SnyUmd/KiCAD/spot/rx-8035_am.pdf

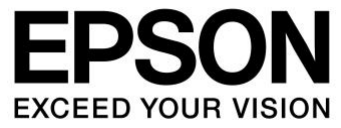
[picture p1: figure]

ETM35J-09

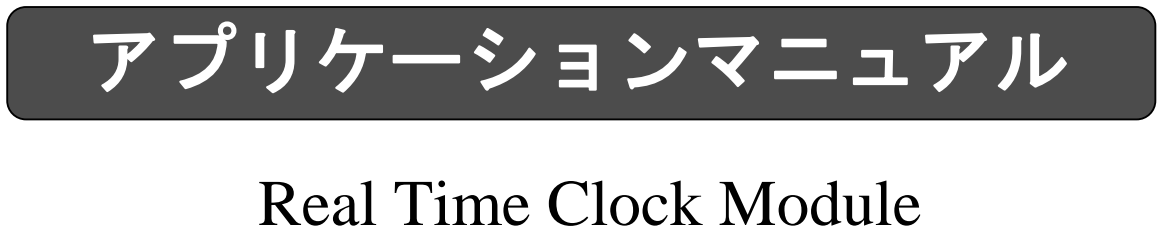
[picture p2: figure]
アプリケーションマニュアル; Real Time Clock Module

# Preliminary

# RX-8035SA/LC

### - 本マニュアルのご使用につきましては、次の点にご留意願います。

1. 本資料の内容については、予告なく変更することがあります。量産設計の際は最新情報をご確認ください。
2. 本資料の一部、または全部を弊社に無断で転載、または、複製など他の目的に使用することは堅くお断りいたします。
3. 本資料に記載される応用回路、プログラム、使用方法等はあくまでも参考情報であり、これらに起因する第三者の知 的財産権およびその他の権利侵害あるいは損害の発生に対し、弊社は如何なる保証を行うものではありません。また、 本資料によって第三者または弊社の知的財産権およびその他の権利の実施権の許諾を行うものではありません。
4. 特性表の数値の大小は、数値線上の大小関係で表します。
5. 輸出管理について
(1) 製品および弊社が提供する技術を輸出等するにあたっては「外国為替および外国貿易法」を遵守し、当該法令の定 める必要な手続をおとりください。
(2) 大量破壊兵器の開発等およびその他の軍事用途に使用する目的をもって製品および弊社が提供する技術を輸出等 しないでください。また、これらに使用するおそれのある第三者に提供しないでください。
6. 製品は一般電子機器に使用されることを意図し設計されたものです。 特別に高信頼性を必要とする以下の特定用途に 使用する場合は、弊社の事前承諾を必ず得て下さい。 承諾無き場合は如何なる責任も負いかねることがあります。 1 宇宙機器（人工衛星・ロケット等）2 輸送車両並びにその制御機器（自動車・航空機・列車・船舶等）
3 生命維持を目的とした医療機器 4 海底中継機器 5 発電所制御機器 6 防災・防犯装置7 交通用機器
8 その他；1 ～7 と同等の信頼性を必要とする用途

本資料に掲載されている会社名、商品名は、各社の商標もしくは登録商標です。

# ETM35J 改定履歴

Rev No. | Date | Page | Description
-05 | 2013/06/10 | | 制定
-08 | 2014/06/18 | 4 | プルダウン抵抗値の仕様記載
| | 15 | タイミングチャート修正：VDD→VOUT 等
-09 | 2017/9/20 | 13,20,30 | VDET に関して 秒桁書き込み後は VDET をクリアしてください。
| | 13 | VDET に関して 2:VDET は VBAT 電圧を監視しています。
| | 7 | 電源切替に関して 電池を先入れする際の注意事項追加
| | 29 | フローチャート新規追加

## RX - 8035 SA / LC

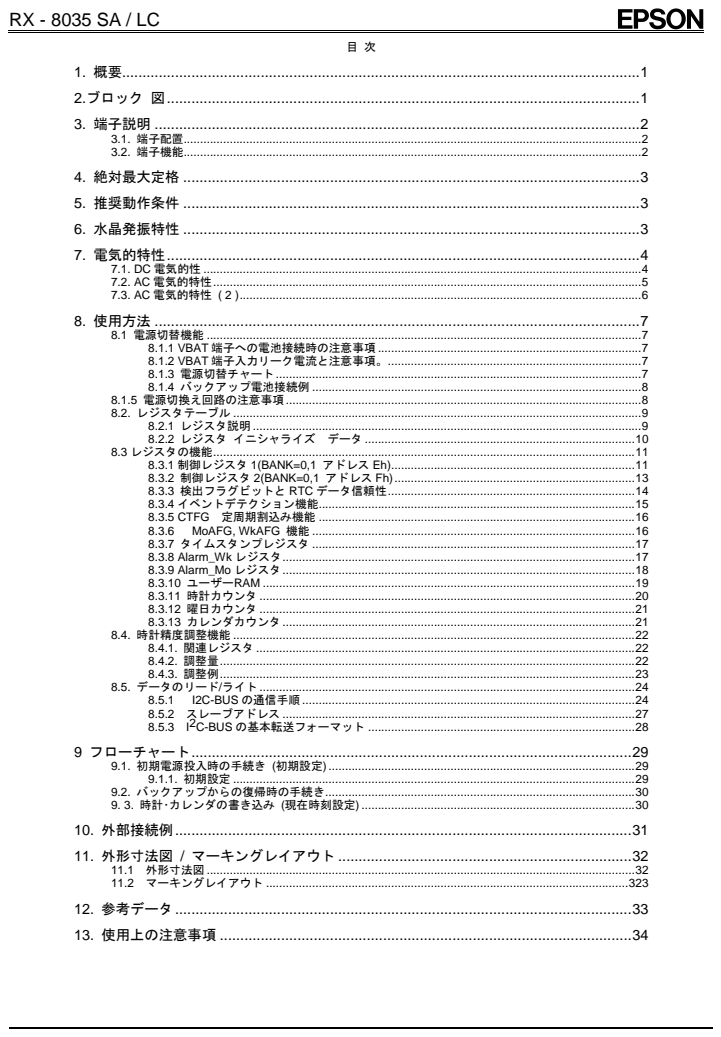
[picture p3: page 4]
2.ブロック 図....................................................................................................................1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

8.2.1 レジスタ説明 ......................................................................................................................9
8.2.2 レジスタ イニシャライズ データ ..................................................................................10

8.3.1 制御レジスタ 1(BANK=0,1 アドレス Eh)..........................................................................11
8.3.2 制御レジスタ 2(BANK=0,1 アドレス Fh).........................................................................13
8.3.3 検出フラグビットと RTC データ信頼性...........................................................................14
8.3.4 イベントデテクション機能................................................................................................15
8.3.5 CTFG 定周期割込み機能 ................................................................................................16
8.3.7 タイムスタンプレジスタ ..................................................................................................17
8.3.8 Alarm_Wk レジスタ...........................................................................................................17
8.3.9 Alarm_Mo レジスタ...........................................................................................................18
8.3.10 ユーザーRAM .................................................................................................................19
8.3.11 時計カウンタ ..................................................................................................................20
8.3.12 曜日カウンタ ..................................................................................................................21
8.3.13 カレンダカウンタ...........................................................................................................21

9.2. バックアップからの復帰時の手続き..............................................................................................30
9. 3. 時計･カレンダの書き込み (現在時刻設定) ...................................................................................30
10. 外部接続例................................................................................................................31

1. 概要

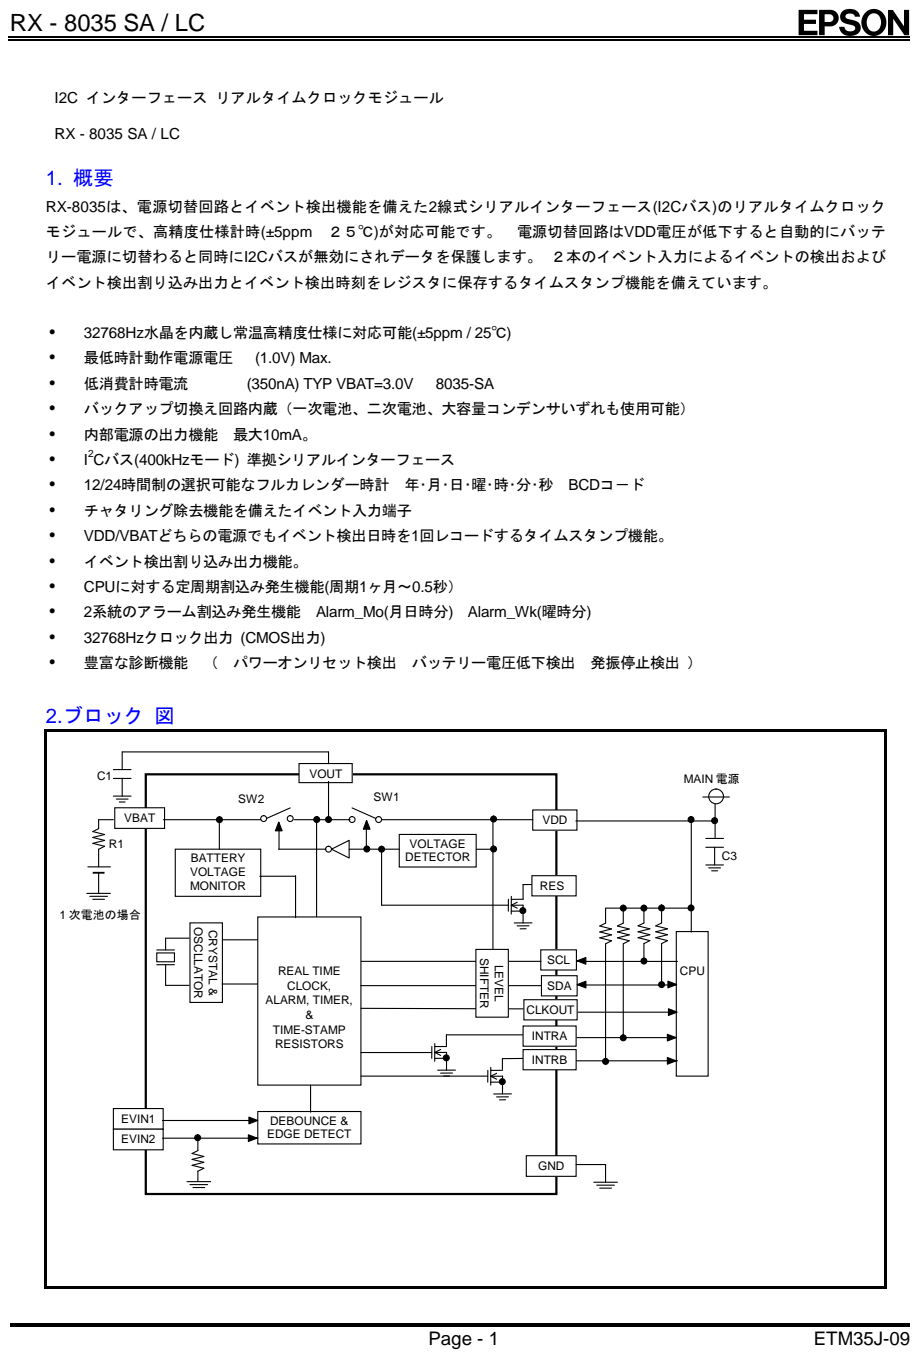
[picture p4: page 5]
Page - 1; ETM35J-09; I2C インターフェース リアルタイムクロックモジュール; 最低時計動作電源電圧; (1.0V) Max.; 低消費計時電流; (350nA) TYP VBAT=3.0V; 2.ブロック 図; GND; VOUT; MAIN 電源; VBAT; VDD; REAL TIME; CPU; CLOCK, ALARM, TIMER, & TIME-STAMP RESISTORS; SDA; BATTERY; VOLTAGE MONITOR; VOLTAGE DETECTOR; CLKOUT; INTRA; INTRB; EVIN1; DEBOUNCE &; EDGE DETECT; OSCLLATOR; CRYSTAL &; EVIN2; RES; SCL; 1 次電池の場合; LEVEL; SHIFTER

RX-8035は、電源切替回路とイベント検出機能を備えた2線式シリアルインターフェース(I2Cバス)のリアルタイムクロック
モジュールで、高精度仕様計時(±5ppm ２５℃)が対応可能です。 電源切替回路はVDD電圧が低下すると自動的にバッテ
リー電源に切替わると同時にI2Cバスが無効にされデータを保護します。 ２本のイベント入力によるイベントの検出および
イベント検出割り込み出力とイベント検出時刻をレジスタに保存するタイムスタンプ機能を備えています。

32768Hz水晶を内蔵し常温高精度仕様に対応可能(±5ppm / 25℃)
バックアップ切換え回路内蔵（一次電池、二次電池、大容量コンデンサいずれも使用可能）
内部電源の出力機能 最大10mA。
2Cバス(400kHzモード) 準拠シリアルインターフェース
12/24時間制の選択可能なフルカレンダー時計 年･月･日･曜･時･分･秒 BCDコ－ド
チャタリング除去機能を備えたイベント入力端子
VDD/VBATどちらの電源でもイベント検出日時を1回レコードするタイムスタンプ機能。
イベント検出割り込み出力機能。
CPUに対する定周期割込み発生機能(周期1ヶ月～0.5秒）
2系統のアラーム割込み発生機能 Alarm_Mo(月日時分) Alarm_Wk(曜時分)
32768Hzクロック出力 (CMOS出力)
豊富な診断機能 （ パワーオンリセット検出 バッテリー電圧低下検出 発振停止検出 ）

## 3. 端子説明

### RX - 8035 LC

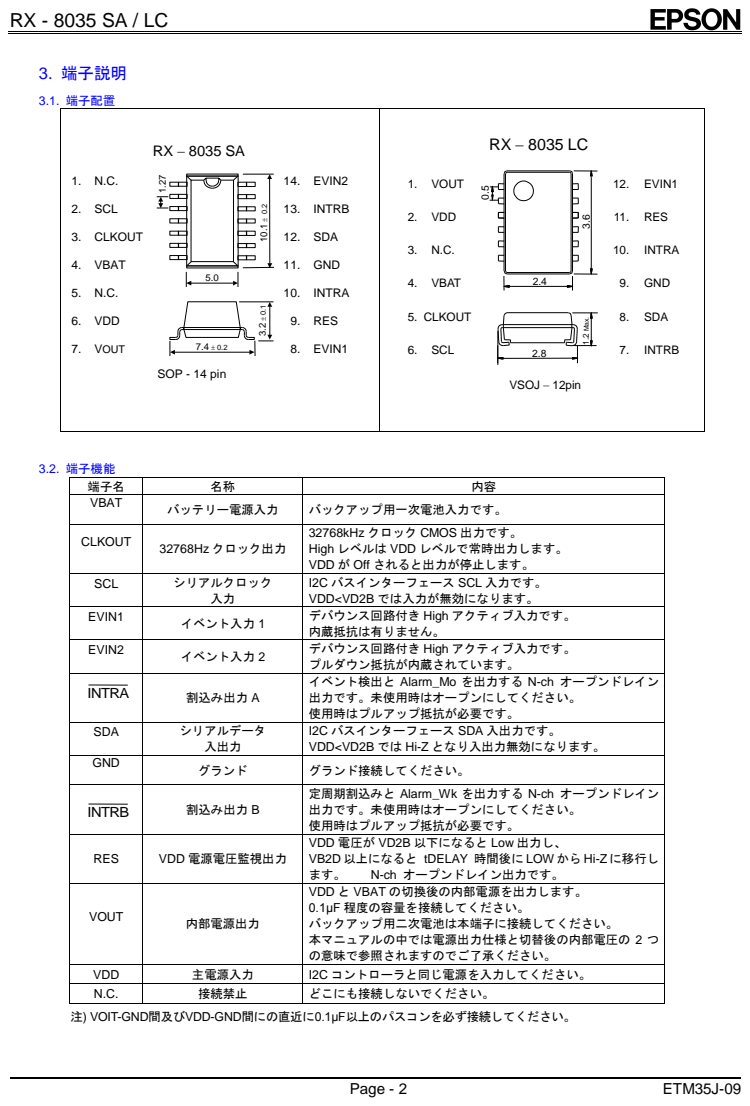
[picture p5: page 6]
Page - 2; ETM35J-09; 3.1. 端子配置; 3.2. 端子機能; 注) VOIT-GND間及びVDD-GND間にの直近に0.1μF以上のパスコンを必ず接続してください。; VOUT; EVIN1; VDD; RES; INTRA; VBAT; GND; 5. CLKOUT; SDA; 6. SCL; 3.6 1.2 Max.; 7. INTRB; VSOJ - 12pin; 14. EVIN2; 2. SCL; 13. INTRB; 3. CLKOUT; 12. SDA; 4. VBAT; 11. GND; 10. INTRA; 6. VDD; 9. RES; 7. VOUT; 8. EVIN1; SOP - 14 pin

端子名 | 名称 | 内容
VBAT | バッテリー電源入力 | バックアップ用一次電池入力です。

CLKOUT | 32768Hz クロック出力 | 32768kHz クロック CMOS 出力です。 High レベルは VDD レベルで常時出力します。 VDD が Off されると出力が停止します。

SCL | シリアルクロック 入力 | I2C バスインターフェース SCL 入力です。 VDD<VD2B では入力が無効になります。

EVIN1 | イベント入力 1 | デバウンス回路付き High アクティブ入力です。 内蔵抵抗は有りません。

EVIN2 | イベント入力 2 | デバウンス回路付き High アクティブ入力です。 プルダウン抵抗が内蔵されています。

INTRA | 割込み出力 A | イベント検出と Alarm_Mo を出力する N-ch オープンドレイン 出力です。未使用時はオープンにしてください。 使用時はプルアップ抵抗が必要です。

SDA | シリアルデータ 入出力 | I2C バスインターフェース SDA 入出力です。 VDD<VD2B では Hi-Z となり入出力無効になります。

GND | グランド | グランド接続してください。

INTRB | 割込み出力 B | 定周期割込みと Alarm_Wk を出力する N-ch オープンドレイン 出力です。未使用時はオープンにしてください。 使用時はプルアップ抵抗が必要です。

RES | VDD 電源電圧監視出力 | VDD 電圧が VD2B 以下になると Low 出力し、 VB2D 以上になると tDELAY 時間後に LOW から Hi-Z に移行し ます。 N-ch オープンドレイン出力です。

VOUT | 内部電源出力 | VDD と VBAT の切換後の内部電源を出力します。 0.1μF 程度の容量を接続してください。 バックアップ用二次電池は本端子に接続してください。 本マニュアルの中では電源出力仕様と切替後の内部電圧の 2 つ の意味で参照されますのでご了承ください。

VDD | 主電源入力 | I2C コントローラと同じ電源を入力してください。
N.C. | 接続禁止 | どこにも接続しないでください。

4. 絶対最大定格 | GND=0 V

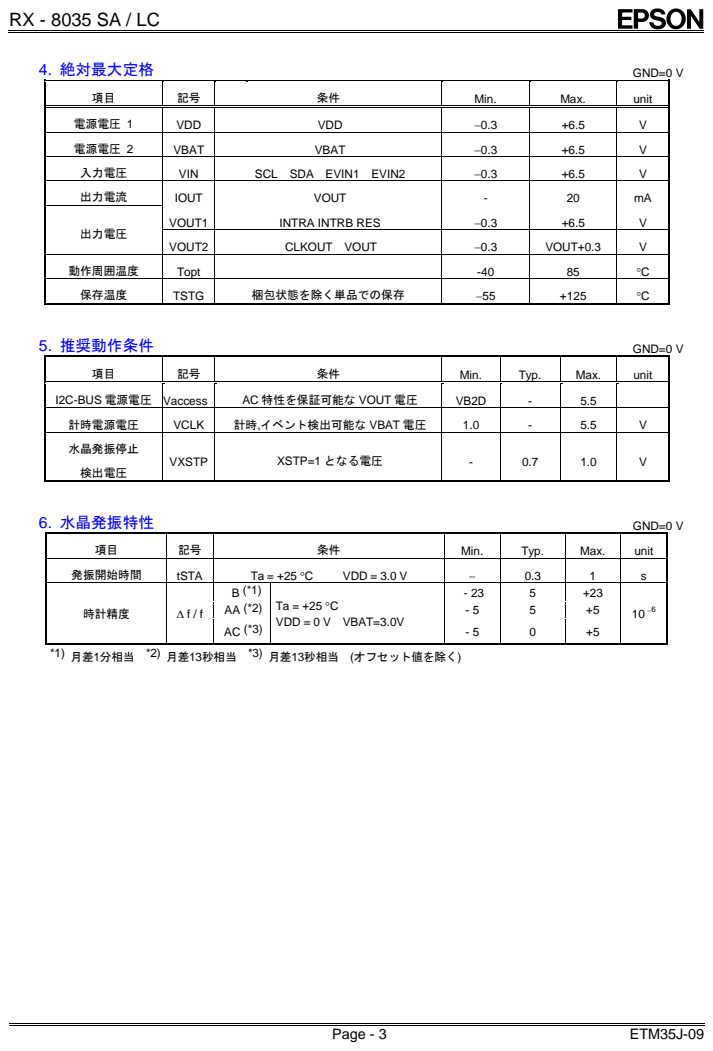
[picture p6: page 7]
Page - 3; ETM35J-09; 5. 推奨動作条件; GND=0 V; 6. 水晶発振特性; *1) 月差1分相当 *2) 月差13秒相当 *3) 月差13秒相当 (オフセット値を除く)

項目 | 記号 | 条件 | Min. | Max. | unit

電源電圧 1 | VDD | VDD | -0.3 | +6.5 | V

電源電圧 2 | VBAT | VBAT | -0.3 | +6.5 | V

入力電圧 | VIN | SCL SDA EVIN1 EVIN2 | -0.3 | +6.5 | V

出力電流 | IOUT | VOUT | - | 20 | mA

出力電圧 | VOUT1 | INTRA INTRB RES | -0.3 | +6.5 | V

VOUT2 | CLKOUT VOUT | -0.3 | VOUT+0.3 | V

動作周囲温度 | Topt | | -40 | 85 | °C

保存温度 | TSTG | 梱包状態を除く単品での保存 | -55 | +125 | °C

項目 | 記号 | 条件 | Min. | Typ. | Max. | unit

I2C-BUS 電源電圧 | Vaccess | AC 特性を保証可能な VOUT 電圧 | VB2D | - | 5.5

計時電源電圧 | VCLK | 計時,イベント検出可能な VBAT 電圧 | 1.0 | - | 5.5 | V

水晶発振停止 検出電圧 | VXSTP | XSTP=1 となる電圧 | - | 0.7 | 1.0 | V

発振開始時間 | tSTA | Ta = +25 °C VDD = 3.0 V | - | 0.3 | 1 | s
時計精度 | Δ f / f | B (*1) | Ta = +25 °C VDD = 0 V VBAT=3.0V | - 23 | 5 | +23

Page - 4 | ETM35J- 09

## 7. 電気的特性

7.1. DC 電気的性

なき場合:GND=0V, VDD=3.0V, Topt=-40～+85°C,
記号 | 項 目 | 端 子 名 | 測定条件 | 最小 | 標準 | 最大 | 単位
VIH1 | “H” 入力電圧 | SCL, SDA | VDD =VB2D～5.5V | 0.8x VDD | | 5.5 | V
VIL1 | “L” 入力電圧 | | | -0.3 | | 0.2x VDD
VIH2 | “H” 入力電圧 | EVIN1, EVIN2 | VOUT=1.0～5.5V | 0.8x VOUT | | 5.5 | V
VIL2 | “L” 入力電圧 | | | -0.3 | | 0.3
IOH | “H” 出力電流 | CLKOUT | VOH=VDD-0.5V | | | -0.5 | mA
IOL1 | “L” 出力電流 | CLKOUT | VOL=0.4V | 0.5 | | | mA
IOL2 | | INTRA , INTRB VDCC | | 2.0
IOL3 | | SDA | | 3.0
IIL | 入力リーク電流 | SCL EVIN1 | VI=5.5V or GND | -0.2 | | 0.2 | µA
IOZ | オフ状態出力 リーク電流 | INTRA , INTRB VDCC , SDA | VO=5.5V or GND | -0.2 | | 0.2 | µA
RDN | プルダウン 抵抗値 | EVIN2 | | 40 | 120 | 400 | kΩ
VD2B | VDD→VBAT 切換電圧 | VDD | Topt=+25°C | 2.328 | 2.40 | 2.472 | V
VB2D | VBAT→VDD 切換電圧 | VDD | Topt=+25°C | 2.396 | 2.52 | 2.544 | V
ΔVDET ΔTopt | 切換電圧 温度係数 | VDD | Topt=-40～+85°C | | ±100 | | ppm/ °C
VDET | VBAT 電圧低下 検出電圧 | VBAT | Topt=-30 to +70°C | 1.10 | 1.25 | 1.40 | V
VOUT1 | VOUT出力電圧 1 | VOUT | Topt=+25°C, VDD=3.0V Iout = 10mA | VDD -0.12 | VDD -0.03 | | V
VOUT2 | VOUT出力電圧 2 | VOUT | Topt=+25°C, VDD=2.0V VBAT=3.0V Iout = 100µA | VBAT -0.08 | VBAT -0.03 | | V
IBATL | VDD オン時 VBAT 端子漏れ電流 | VBAT | VDD=3.0V VBAT=0V or 5.5V SCL=SDA=0V CLKOUT = OPEN | -1.0 | 0.01 | 1.0 | µA
IBAT1 | RX 8035 SA 計時消費電流 | VBAT | VDD=0V VBAT=3V SCL=SDA=0V EVIN1=EVIN2= GND VLKOUT = OPEN | - | 350 | 1200 | nA
IBAT2 | RX 8035 LC 計時消費電流 | | | | 400
IDD | VDD 消費電流 | VDD | VDD=3V, VBAT=0V SCL=SDA=0V EVIN1=EVIN2=GND CLKOUT = OPEN | - | 1400 | 2500 | nA

### ( *1) 入力リーク電流 参考値

条件: SCL 端子 VOUT=3.0V VIN=0V or 5.5V -40°C ~ +85°C

### 上記条件で任意ロットにおけるワースト値：±17nA

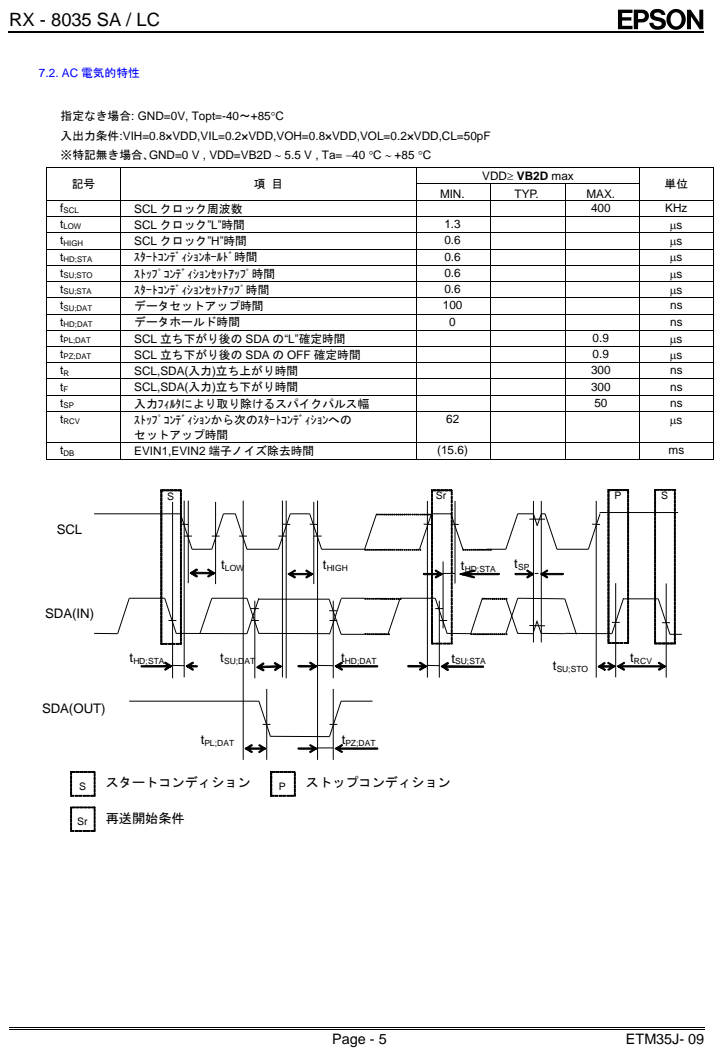
[picture p7: page 9]
Page - 5; ETM35J- 09; 7.2. AC 電気的特性; SDA(OUT); SCL; tPZ;DAT; tHIGH; tSU;DAT; tHD;STA; tSP; tSU;STO; tLOW; tSU;STA; SDA(IN); tPL;DAT; スタートコンディション; ストップコンディション; 再送開始条件; tHD;DAT; tRCV

指定なき場合: GND=0V, Topt=-40～+85°C
入出力条件:VIH=0.8×VDD,VIL=0.2×VDD,VOH=0.8×VDD,VOL=0.2×VDD,CL=50pF
※特記無き場合､GND=0 V , VDD=VB2D ~ 5.5 V , Ta= -40 °C ~ +85 °C

記号 | 項 目 | VDD≥ VB2D max | 単位

MIN. | TYP. | MAX.

fSCL | SCL クロック周波数 | | | 400 | KHz
tLOW | SCL クロック”L”時間 | 1.3 | | | µs
tHIGH | SCL クロック”H”時間 | 0.6 | | | µs
tHD;STA | ｽﾀｰﾄｺﾝﾃﾞｨｼｮﾝﾎｰﾙﾄﾞ時間 | 0.6 | | | µs
tSU;STO | ｽﾄｯﾌﾟｺﾝﾃﾞｨｼｮﾝｾｯﾄｱｯﾌﾟ時間 | 0.6 | | | µs
tSU;STA | ｽﾀｰﾄｺﾝﾃﾞｨｼｮﾝｾｯﾄｱｯﾌﾟ時間 | 0.6 | | | µs
tSU;DAT | データセットアップ時間 | 100 | | | ns
tHD;DAT | データホールド時間 | 0 | | | ns
tPL;DAT | SCL 立ち下がり後の SDA の“L”確定時間 | | | 0.9 | µs
tPZ;DAT | SCL 立ち下がり後の SDA の OFF 確定時間 | | | 0.9 | µs
tR | SCL,SDA(入力)立ち上がり時間 | | | 300 | ns
tF | SCL,SDA(入力)立ち下がり時間 | | | 300 | ns
tSP | 入力ﾌｨﾙﾀにより取り除けるスパイクパルス幅 | | | 50 | ns
tRCV | ｽﾄｯﾌﾟｺﾝﾃﾞｨｼｮﾝから次のｽﾀｰﾄｺﾝﾃﾞｨｼｮﾝへの セットアップ時間 | 62 | | | µs

tDB | EVIN1,EVIN2 端子ノイズ除去時間 | (15.6) | | | ms

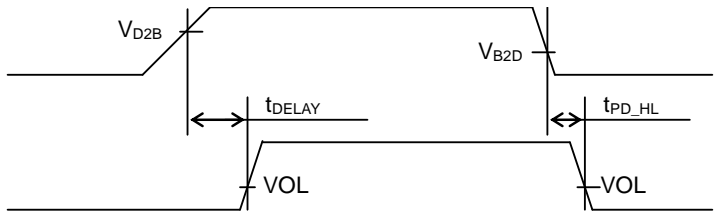
[picture p8: figure]
tDELAY; VOL; tPD_HL
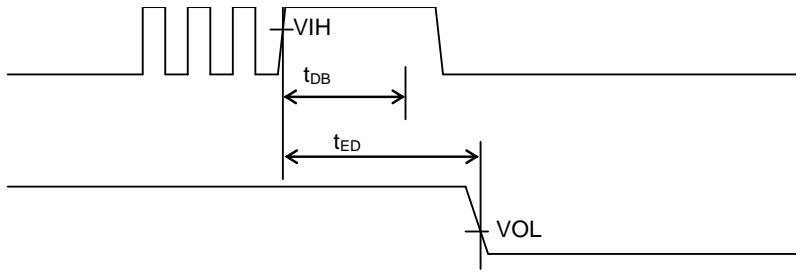
[picture p9: figure]
tDB; VOL; VIH; tED

Page - 6 | ETM35J- 09
7.3. AC電気的特性 ( 2 )

指定なき場合: GND=0V, Topt=-40～+85°C, VBAT=3.0V 入出力条件:CL=50pF
記号 | 項 目 | 測定条件 | MIN. | TYP. | MAX. | 単位
tDELAY | ボルテージディテクタ 出力遅延時間 | 計時動作時、VOUT ≥ VB2D | Typ -4 | (105) | Typ +4 | ms
tPD_HL | ボルテージディテクタ 伝播遅延時間 | | | 15 | | µs
*1) tDB | EVIN1,EVIN2 端子 ノイズ除去時間 | 計時動作時 | Typ -4 | 35 or 1996 | Typ +4 | ms
tED | イベント入力検出時間 | 計時動作時 | Typ -4 | tDB+7.8 | Typ +4 | ms

*1) tDBはDBSLビットで35ms or 1996msが選択可能です。

RES

VDD

INTRA

EVIN

Page - 7 | ETM35J- 09

## 8. 使用方法

8.1 電源切替機能

RX-8035 は 3 つの電源端子(VOUT,VDD,VBAT)を持っています。VOUT は RTC の内部電源が現れます。

VDD 電源電圧が VD2B より低いときは VBAT から電源が自動供給されて VOUT には VBAT 電圧が現れ、

VB2D より高い場合は、VDD から電源が供給されて VOUT には VDD 電圧が現れます。 VDD電源電圧がVD2B電圧より低下するとI

2Cバスインターフェースが自動的に無効になりRTC内部データ

が保護されます。
8.1.1 VBAT 端子への電池接続時の注意事項

電源切替回路はVDD電源の供給によって初期化されるため、VDDが供給される前にバックアップ用電池をセットされた場合は VDD電源で動作する電源切替SWが初期化されずVBAT端子に100μA前後のリーク電流が流れ込む事が有ります。 このような電池先入れ時のリーク電流を解消するためには以下のいずれかの処理を実施してください。
1) VDD供給状態で電池をセットしてください。
2) 電池セット後に2.47V以上の電圧を10ms以上VDD端子に供給してください。
3) 2.47V以上の電池セット後にVBAT端子とVDD端子を10ms以上ショートしてください。 OFF状態のVDDのインピーダンスが低い場合はVBATの電池電圧がVDDに引き込まれて2.47Vに達しない場合も想定されま す。
ショート時のVDD電圧をご確認ください。
以上の処理以降はVDD,VBATの電圧変動に追従して切替動作が行われリーク電流が発生することは有りません。

8.1.2 VBAT 端子入力リーク電流と注意事項。

本書 7.2 DC 電気的特性仕様の IBATL 特性の任意ロットにおける参考値は以下のとおりです。

VDD = 3.0V VBAT = 5.5V : Max:+9nA (-40 °C ~ +85 °C)

VDD = 3.0V VBAT = 0.0V : Max:-3nA (-40 °C ~ +85 °C)
VDD電圧がVD2B(Typ. 2.4V), VB2D(Typ. 2.47V) 付近ではVDD側およびVBAT側の切替SWが両方ONまたはOFFに近 い状態となりVDD-VBAT間がショートされる、あるいはどちらからも電源供給されないような瞬間があります。 VDD電圧が上記の切替電圧付近に停滞せず、できるだけ速やかにMAX～MIN間を遷移するようにご配慮ください。 8.1.3 電源切替チャート

下図にVDDとVBATとVOUTの関係をタイミングチャートで示します。

VOUT

VB2D

VDD
0V

VBAT

0V

I | II | III | II | III

VD2B

状態 | II | IV

上記タイミングチャートの説明
状態 | 説明
I | VDD,VBAT 端子共に 0V の時に VDD だけを供給していくと、徐々に内部電源に供給され、VOUT は VDD の半分くらいの電圧で追従します。
II | VDD が VB2D を超えると、VOUT は VDD と等しい電圧まで上昇し、その後、VDD に追従します。 VDD が VB2D より高い電圧では VDD=VOUT となります。
III | VDD が VD2B を下回ると、VOUT は VBAT と等しくなります。
IV | VDD 供給が無い状態(初期電源投入)で VBAT だけが供給されると、VDD が供給されるまでは VOUT が不安定になり、VBAT 端子に 100μA 前後の入力リーク電流が生じる場合が有ります。

電源切換回路が不安定です。

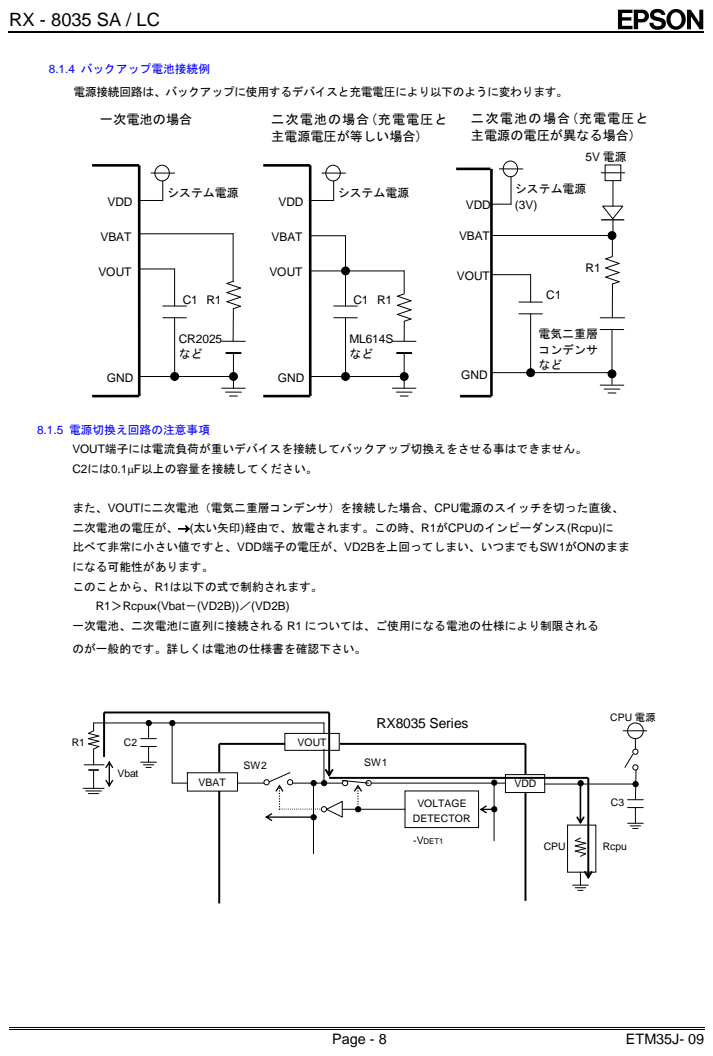
[picture p10: page 12]
Page - 8; ETM35J- 09; 8.1.4 バックアップ電池接続例; 電源接続回路は、バックアップに使用するデバイスと充電電圧により以下のように変わります。; 8.1.5 電源切換え回路の注意事項; VOUT端子には電流負荷が重いデバイスを接続してバックアップ切換えをさせる事はできません。; C2には0.1µF以上の容量を接続してください。; のが一般的です。詳しくは電池の仕様書を確認下さい。; VBAT; VOUT; VDD; GND; システム電源; 電気二重層 コンデンサ など; 二次電池の場合(充電電圧と 主電源の電圧が異なる場合); 二次電池の場合(充電電圧と 主電源電圧が等しい場合); 一次電池の場合; CPU 電源; VOLTAGE; DETECTOR; CPU; Vbat; Rcpu; RX8035 Series; -VDET1

また、VOUTに二次電池（電気二重層コンデンサ）を接続した場合、CPU電源のスイッチを切った直後、
二次電池の電圧が、→(太い矢印)経由で、放電されます。この時、R1がCPUのインピーダンス(Rcpu)に
比べて非常に小さい値ですと、VDD端子の電圧が、VD2Bを上回ってしまい、いつまでもSW1がONのまま
になる可能性があります。
このことから、R1は以下の式で制約されます。
R1＞Rcpu×(Vbat－(VD2B))／(VD2B)
一次電池、二次電池に直列に接続される R1 については、ご使用になる電池の仕様により制限される

Page - 9 | ETM35J- 09
8.2. レジスタテーブル

●BANK=0
Adrs | Function | Data
D7 | D6 | D5 | D4 | D3 | D2 | D1 | D0
0h | Seconds | - | S40 | S20 | S10 | S8 | S4 | S2 | S1
1h | Minutes | - | M40 | M20 | M10 | M8 | M4 | M2 | M1
2h | Hours | 12 /24 | - | H20 P/ A | H10 | H8 | H4 | H2 | H1
3h | Day of week | - | - | - | - | - | W4 | W2 | W1
4h | Day of month | - | - | D20 | D10 | D8 | D4 | D2 | D1
5h | Months | - | - | - | MO10 | MO8 | MO4 | MO2 | MO1
6h | Years | Y80 | Y40 | Y20 | Y10 | Y8 | Y4 | Y2 | Y1
7h | Digital Offset | TEST | F6 | F5 | F4 | F3 | F2 | F1 | F0
8h | Alarm_Wk ; Minute | * | WkM40 | WkM20 | WkM10 | WkM8 | WkM4 | WkM2 | WkM1
9h | Alarm_Wk ; Hour | * | * | WkH20 A WkP/ | WkH10 | WkH8 | WkH4 | WkH2 | WkH1
Ah | Alarm_Wk; Day of week. | * | WkW6 | WkW5 | WkW4 | WkW3 | WkW2 | WkW1 | WkW0
Bh | Alarm_Mo ; Minute | * | MoM40 | MoM20 | MoM10 | MoM8 | MoM4 | MoM2 | MoM1
Ch | Alarm_Mo ; Hour | * | * | MoH20 MoP/ A | MoH10 | MoH8 | MoH4 | MoH2 | MoH1
Dh | RAM | * | * | * | * | * | * | * | *
Eh | Control 1 | WkALE | MoALE | DBSL | EDEN | TEST | CT2 | CT1 | CT0
Fh | Control 2 | BANK TSFG | VDET | XSTP | PON | EDFG | CTFG | WkAFG | MoAFG

●BANK=1
Adrs | Function | Data
D7 | D6 | D5 | D4 | D3 | D2 | D1 | D0
0h | Time-stamp Sec. | EDCH1 | TS40 | TS20 | TS10 | TS8 | TS4 | TS2 | TS1
1h | Time-stamp Min | EDCH2 | TM40 | TM20 | TM10 | TM8 | TM4 | TM2 | TM1
2h | Time-stamp Hour | - | - | TH20 TP/ A | TH10 | TH8 | TH4 | TH2 | TH1
3h | Time-stamp Day of Week | - | - | - | - | - | TW4 | TW2 | TW1
4h | Time-stamp Day of Month | - | - | TD20 | TD10 | TD8 | TD4 | TD2 | TD1
5h | Time-stamp Month | - | - | - | TMO10 | TMO8 | TMO4 | TMO2 | TMO1
6h | Time-stamp Year | TY80 | TY40 | TY20 | TY10 | TY8 | TY4 | TY2 | TY1
7h | Digital Offset | Same as BANK0
8h | Reserved | - | - | - | - | - | - | - | -
9h | | - | - | - | - | - | - | - | -
Ah | | - | - | - | - | - | - | - | -
Bh | Alarm_Mo ; Day | DYE | * | MoD20 | MoD10 | MoD8 | MoD4 | MoD2 | MoD1
Ch | Alarm_Mo ; Month | MOE | * | * | MoMO10 | MoMO8 | MoMO4 | MoMO2 | MoMO1
Dh | RAM | Same as BANK0
Eh | Control 1 | Same as BANK0
Fh | Control 2 | Same as BANK0
8.2.1 レジスタ説明

“ - “ ビットへの書き込みは無効で、読み出し値は常に "0" です。
“ *“ビットは読み出しと任意値の書き込みが可能です。

MoALE=0 の時は Alarm_Mo レジスタ(BANK=0 の 8～Ah)が、WkALE=0 の時は Alarm_Wk レジスタ

(BANK=0 の Bh,Ch と BANK=1 の Bh,Ch)が、それぞれユーザーRAM として使用できます。 パワーオンリセットフラグ(PON ) が 1 にセットされると、時計誤差補正レジスタ,Alarm_Mo･Alarm_Wk

レジスタ,ユーザーRAM, Control1, VDET, PON、XSTP を除いた Control2 の全ビットは 0 リセットされ

VDET, XSTP, ON は 1 になります。 VDET, XSTP, PON への"1"書き込みは無効です。

Adress0(秒)の書き込み後は VDET ビットをゼロクリアしてください。

Page - 10 | ETM35J- 09

8.2.2 レジスタ イニシャライズ データ

●BANK=0
Adrs | Function | Data
D7 | D6 | D5 | D4 | D3 | D2 | D1 | D0
0h | seconds | -
1h | minutes | -
2h | houts | | -
3h | Day of week | - | - | - | - | -
4h | Day of month | 0 | 0
5h | Month | 0 | 0 | 0
6h | Years
7h | Digital offset | 0 | 0 | 0 | 0 | 0 | 0 | 0 | 0
8h | Alarm_Wk ; Minute | 0 | 0 | 0 | 0 | 0 | 0 | 0 | 0
9h | Alarm_Wk ; Hour | 0 | 0 | 0 | 0 | 0 | 0 | 0 | 0
Ah | Alarm_Wk ; Day of Week | 0 | 0 | 0 | 0 | 0 | 0 | 0 | 0
Bh | Alarm_Mo ; Minute | 0 | 0 | 0 | 0 | 0 | 0 | 0 | 0
Ch | Alarm_Mo ; Hour | 0 | 0 | 0 | 0 | 0 | 0 | 0 | 0
Dh | RAM | 0 | 0 | 0 | 0 | 0 | 0 | 0 | 0
Eh | Control 1 | 0 | 0 | 0 | 0 | 0 | 0 | 0 | 0
Fh | Control 2 | 0 | 1 | 1 | 1 | 0 | 0 | 0 | 0

●BANK=1
Adrs | Function | Data
D7 | D6 | D5 | D4 | D3 | D2 | D1 | D0
0h | Time-stamp Sec. | 0 | 0 | 0 | 0 | 0 | 0 | 0 | 0
1h | Time-stamp Min | 0 | 0 | 0 | 0 | 0 | 0 | 0 | 0
2h | Time-stamp Hour | 0 | 0 | 0 | 0 | 0 | 0 | 0 | 0
3h | Time-stamp Day of Week | 0 | 0 | 0 | 0 | 0 | 0 | 0 | 0
4h | Time-stamp Day of Month | 0 | 0 | 0 | 0 | 0 | 0 | 0 | 0
5h | Time-stamp Month | 0 | 0 | 0 | 0 | 0 | 0 | 0 | 0
6h | Time-stamp Year | 0 | 0 | 0 | 0 | 0 | 0 | 0 | 0
7h | Digital offset | BANK0 と同じ
8h | Reserved | - | - | - | - | - | - | - | -
9h | | - | - | - | - | - | - | - | -
Ah | | - | - | - | - | - | - | - | -
Bh | Alarm_Mo ; Day | 0 | 0 | 0 | 0 | 0 | 0 | 0 | 0
Ch | Alarm_Mo ; Month | 0 | 0 | 0 | 0 | 0 | 0 | 0 | 0
Dh | RAM | BANK0 と同じ
Eh | Control 1 | BANK0 と同じ
Fh | Control 2 | BANK0 と同じ

イニシャライズデータの記号説明
1) “ - “ ビットの読み出し値は常に "0" で書き込みは無効です。
2) “ 0 “ビットはパワーオンリセット発生によってゼロにクリアされるビットです。
3) “ 1 “ビットはパワーオンリセット発生によって"1"にセットされるビットです。
4) 斜線ビットはパワーオン時のデータは不定です。
*3 パワーオンリセットの発生はPONフラグで確認可能です。

Page - 11 | ETM35J- 09

8.3 レジスタの機能

8.3.1 制御レジスタ 1(BANK=0,1 アドレス Eh)

D7 | D6 | D5 | D4 | D3 | D2 | D1 | D0
MoALE | WkALE | DBSL | EDEN | TEST | CT2 | CT1 | CT0 | (Write 時)
MoALE | WkALE | DBSL | EDEN | TEST | CT2 | CT1 | CT0 | (Read 時)
0 | 0 | 0 | 0 | 0 | 0 | 0 | 0 | (Default 値 *)
*) Default値：電源オン後、または電源電圧低下等によりPON=1となった時に自動設定される値です。
(1) MoALE,WkALE アラーム月,アラーム曜イネーブルビット
MoALE WkALE | 設 定 内 容
0 | Alarm_Mo, Alarm_Wk 一致動作無効 | (Default 値)
1 | Alarm_Mo, Alarm_Wk 一致動作有効
MoALE=WkALEが共に0の時は、アラーム設定レジスタ7バイト(BANK=0のアドレス8～Chと、

BANK=1のアドレスB,Ch)はユーザーRAMとして使用可能です。

(2) DBSL デバウンス時間切替ビット
DBSL | 設 定 内 容
0 | EVIN1/2 入力のデバウンス時間を 1996ms(typ)に設定 | (Default 値)
1 | EVIN1/2 入力のデバウンス時間を | 35ms(typ)に設定
イベントデテクション機能の有効／無効を設定します。Default値は0(1996ms)です。
(3) EDEN イベントデデクション機能イネーブルビット
EDEN | 設 定 内 容
0 | イベントデテクション機能無効 | (Default 値)
1 | イベントデテクション機能有効
イベントデテクション機能の有効／無効を設定します。Default値は0(無効)です。

EDENを０にクリアすると、以下のタイムスタンプデータが全て0クリアされますので、

タイムスタンプデータを取りこぼさないようにご配慮ください。

BANK=1のアドレス０から６までのタイムスタンプレジスタビットおよびアドレスＦのEDFGビット。

(4) TEST テスト用ビット
TEST | 設 定 内 容
0 | 通常動作モード | (Default 値)
1 | テストモード
テスト用ビットは、ICテスト用のビットです。常に0にクリアしてください。

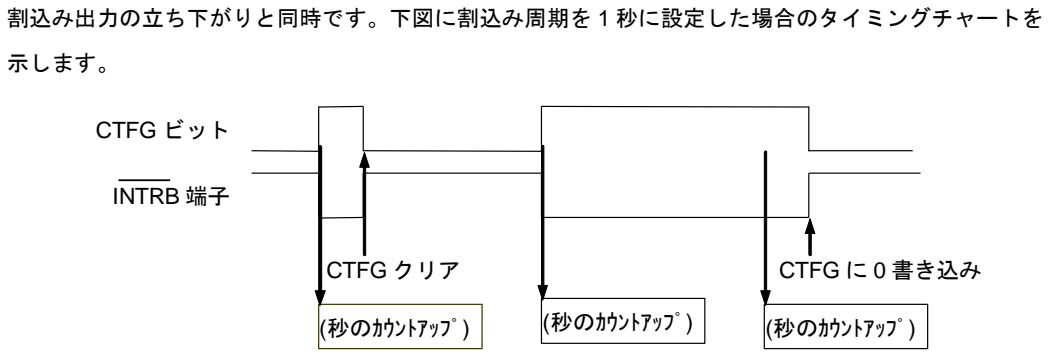
[picture p11: figure]
割込み出力の立ち下がりと同時です。下図に割込み周期を 1 秒に設定した場合のタイミングチャートを; 示します。; INTRB 端子; (秒のｶｳﾝﾄｱｯﾌﾟ); CTFG に 0 書き込み; CTFG ビット; CTFG クリア

Page - 12 | ETM35J- 09
(5) CT2,CT1,CT0 定周期割込み選択ビット
CT2 | CT1 | CT0 | 設 定 内 容
割込モード | 周 期 と 立ち下がりタイミング
0 | 0 | 0 | - | OFF(H) | (Default 値)
0 | 0 | 1 | - | L 固定
0 | 1 | 0 | パルスモード *1) | 2Hz(Duty50%)
0 | 1 | 1 | パルスモード *1) | 1Hz(Duty50%)
1 | 0 | 0 | レベルモード *2) | 1 秒に 1 度（ 秒更新と同時 ）
1 | 0 | 1 | レベルモード *2) | 1 分に１度（ 毎分 00 秒 ）
1 | 1 | 0 | レベルモード *2) | 1 時間に１度（ 毎時 00 分 00 秒 ）
1 | 1 | 1 | レベルモード *2) | 1 月に１度 (毎月 1 日 00 時 00 分 00 秒)

*1) パルスモード：2Hz,1Hz のクロックパルスを出力します。秒のカウントアップとの関連は下図を参照

下さい。

*1 ) パルスモードにおいて、秒のカウントアップは出力立ち下がりエッジから約46µs遅れます。

このため出力の立ち下がり直後に時刻を読み出すと、RTCの計時時刻に比べて、見掛け上約1秒遅れた時刻

が読み出される場合があります。

秒カウンタの書き換えを行うと秒未満のカウンタもリセットされるためINTRB端子は1度Lになります。

*2 ) レベルモード：割込み周期として 1 秒、1 分、1 時間、1 ヶ月を選択可能。秒のカウントアップは

*1), *2) 時計誤差補正回路使用時は、20秒または1分に1回定周期割込みの周期が変化します。

パルスモード：1Hzの出力パルスのH期間が最大±3.784msec増減します。

Dutyは50±0.3784%になります。

2Hzの場合、出力パルスのL期間が最大±3.784msec増減します。Dutyは50±0.7568%になります。

レベルモード：1秒間の周期が最大±3.784msec増減します。

INTRB 端子

秒カウンタの書き換え

CTFG ビット

約 46µs

秒桁上げ

Page - 13 | ETM35J- 09

8.3.2 制御レジスタ 2(BANK=0,1 アドレス Fh)

D7 | D6 | D5 | D4 | D3 | D2 | D1 | D0
BANK | VDET | XSTP | PON | EDFG | CTFG | WkAFG | MoAFG | (Write 時)
TSFG | VDET | XSTP | PON | EDFG | CTFG | WkAFG | MoAFG | (Read 時)
0 | 1 | 1 | 1 | 0 | 0 | 0 | 0 | Default 値 *)
*) Default値：0Vからの電源オン、または電源電圧低下等によりPON=1となった時に自動設定される値です。

(D7) BANK BANK 切換えビット
内部アドレス機能を切り替えます。Write専用ビットです。
BANK | 設 定 内 容
0 | BANK=0 の内部アドレスを指定します | (Default 値)
1 | BANK=1 の内部アドレスを指定します

(D7) TSFG タイムスタンプデータ有効有無判定フラグビット イベント入力発生後、EDFGビットが0→1となった時にXSTPビットとVDETビットがともに0の場合、TSFG=1 となります。 XSTPビットとVDETビットの少なくとも一つが1の場合、TSFG=0となります。 タイムスタンプデータの有効／無効の判定に使用できます。Read専用ビットです。
TSFG | 設 定 内 容
0 | タイムスタンプデータは無効です | (Default 値)
1 | タイムスタンプデータは有効です
(D6) VDET | VBAT 電圧低下検出フラグビット
1度、VDETが1になると、監視動作は停止し、１がホールドされます。VDETはゼロクリアだけが可能で、 0を書き込むと監視動作を再開します。１の書き込みは無効です。 VDETは毎秒更新時に比較された結果を示し、１になった場合はゼロクリアするまで１が保持されます。 １からゼロに更新されることはありません。 検出動作中に秒桁データが書き込まれるとタイミングによって VBATがVDET電圧以上でもVDETが１にセットされる場合が有ります。 このため秒桁の書き込み後はVDETをクリアしてください。
VDET | 設 定 内 容
0 | VBAT が監視電圧(VDET)以上です
1 | VBAT が監視電圧(VDET)以下です | (Default 値)

(D5) XSTP 発振停止検出フラグビット
内蔵水晶発振の停止を検出すると1になり、ゼロクリアするまで1を維持します。 過去に発振が停止した履歴を確認できます。１の書き込みでは何も起りません。
XSTP | 設 定 内 容
0 | 内蔵水晶は正常発振状態を維持しています
1 | 水晶発振の停止を検出した履歴が有ります | (Default 値)

(D4) PON パワーオンリセットフラグビット
パワーオンリセット検出用ビットです。
･ 0Vから初期電源投入された場合に１にセットされてゼロクリアするまで維持されます。
XSTP, VDETと組み合わせて、時計･カレンダデ－タの信頼度の判定に応用可能です。

･ このビットが1の時、時計誤差補正レジスタ,Alarm_Mo･Alarm_Wkレジスタ,ユーザーRAM,Control1, PON,

XSTP､VDETを除くControl2の各ビットはリセットされて0になり、PON, XSTP, VDETは1になります。 この結果、INTRA,INTRB 各端子は出力を停止しますWkAFG。
･ PONの0のみ書き込みによるクリアだけが可能です。1の書き込みでは何も起こりません。 パワーオンリセットの発生のためには、VDD,VBATの両電圧を0.2V以下で5秒以上維持してください。
PON | 設 定 内 容
0 | 通常状態
1 | パワーオンリセット検出 | (Default 値)

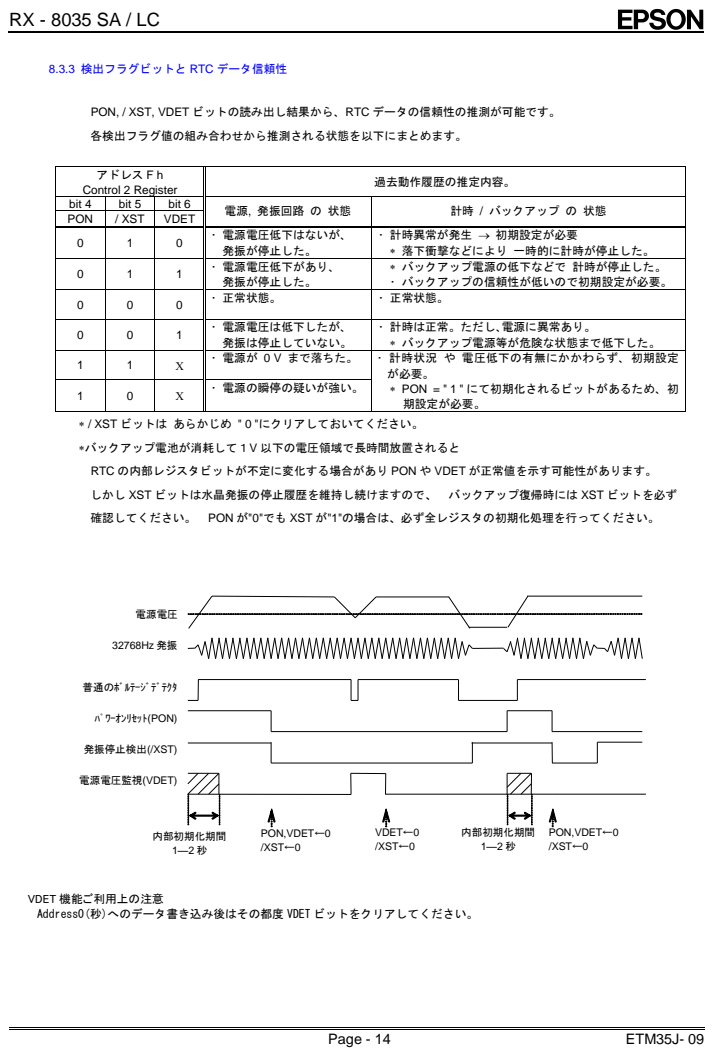
[picture p12: page 18]
Page - 14; ETM35J- 09; 各検出フラグ値の組み合わせから推測される状態を以下にまとめます。; *バックアップ電池が消耗して１V 以下の電圧領域で長時間放置されると; ﾊﾟﾜｰｵﾝﾘｾｯﾄ(PON); 発振停止検出(/XST); 普通のﾎﾞﾙﾃｰｼﾞﾃﾞﾃｸﾀ; VDET←0 /XST←0; 電源電圧; PON,VDET←0 /XST←0; 電源電圧監視(VDET); 内部初期化期間 1―2 秒

8.3.3 検出フラグビットと RTC データ信頼性

PON, / XST, VDET ビットの読み出し結果から､ RTC データの信頼性の推測が可能です。

アドレス F h Control 2 Register | 過去動作履歴の推定内容。

bit 4 | / XST bit 5 | VDET bit 6 | 電源, 発振回路 の 状態 | 計時 / バックアップ の 状態 PON

0 | 1 | 0 | ･ 電源電圧低下はないが､ 発振が停止した。 | ･ 計時異常が発生 → 初期設定が必要 * 落下衝撃などにより 一時的に計時が停止した。

0 | 1 | 1 | ･ 電源電圧低下があり､ 発振が停止した。 | * バックアップ電源の低下などで 計時が停止した。 ･ バックアップの信頼性が低いので初期設定が必要。

0 | 0 | 0 | ･ 正常状態。 | ･ 正常状態。

0 | 0 | 1 | ･ 電源電圧は低下したが､ 発振は停止していない。 | ･ 計時は正常。ただし､電源に異常あり。 * バックアップ電源等が危険な状態まで低下した。

1 | 1 | C | ･ 電源が 0 V まで落ちた。 | ･ 計時状況 や 電圧低下の有無にかかわらず､ 初期設定 が必要。 * PON = " 1 " にて初期化されるビットがあるため､ 初

0 | C | ･ 電源の瞬停の疑いが強い。 | 期設定が必要。 1

* / XST ビットは あらかじめ " 0 "にクリアしておいてください。

RTC の内部レジスタビットが不定に変化する場合があり PON や VDET が正常値を示す可能性があります。

しかし XST ビットは水晶発振の停止履歴を維持し続けますので、 バックアップ復帰時には XST ビットを必ず

確認してください。 PON が"0"でも XST が"1"の場合は、必ず全レジスタの初期化処理を行ってください。

VDET 機能ご利用上の注意
Address0(秒)へのデータ書き込み後はその都度 VDET ビットをクリアしてください。

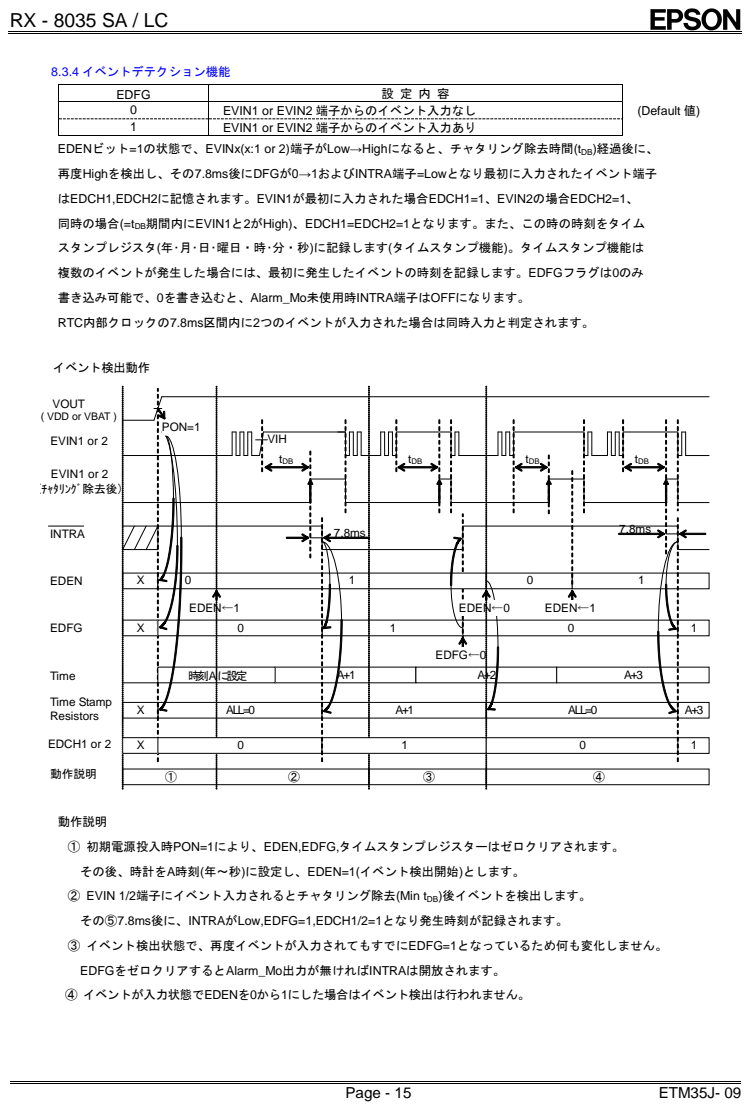
[picture p13: page 19]
Page - 15; ETM35J- 09; 8.3.4 イベントデテクション機能; EDFG; EVIN1 or EVIN2 端子からのイベント入力なし; (Default 値); EVIN1 or EVIN2 端子からのイベント入力あり; 再度Highを検出し、その7.8ms後にDFGが0→1およびINTRA端子=Lowとなり最初に入力されたイベント端子; はEDCH1,EDCH2に記憶されます。EVIN1が最初に入力された場合EDCH1=1、EVIN2の場合EDCH2=1、; 複数のイベントが発生した場合には、最初に発生したイベントの時刻を記録します。EDFGフラグは0のみ; 書き込み可能で、0を書き込むと、Alarm_Mo未使用時INTRA端子はOFFになります。; RTC内部クロックの7.8ms区間内に2つのイベントが入力された場合は同時入力と判定されます。; イベント検出動作; 動作説明; その⑤7.8ms後に、INTRAがLow,EDFG=1,EDCH1/2=1となり発生時刻が記録されます。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

EDENビット=1の状態で、EVINx(x:1 or 2)端子がLow→Highになると、チャタリング除去時間(tDB)経過後に、

同時の場合(=tDB期間内にEVIN1と2がHigh)、EDCH1=EDCH2=1となります。また、この時の時刻をタイム

スタンプレジスタ(年･月･日･曜日・時･分・秒)に記録します(タイムスタンプ機能)。タイムスタンプ機能は

VOUT
( VDD or VBAT )

① 初期電源投入時PON=1により、EDEN,EDFG,タイムスタンプレジスターはゼロクリアされます。

その後、時計をA時刻(年～秒)に設定し、EDEN=1(イベント検出開始)とします。

② EVIN 1/2端子にイベント入力されるとチャタリング除去(Min tDB)後イベントを検出します。

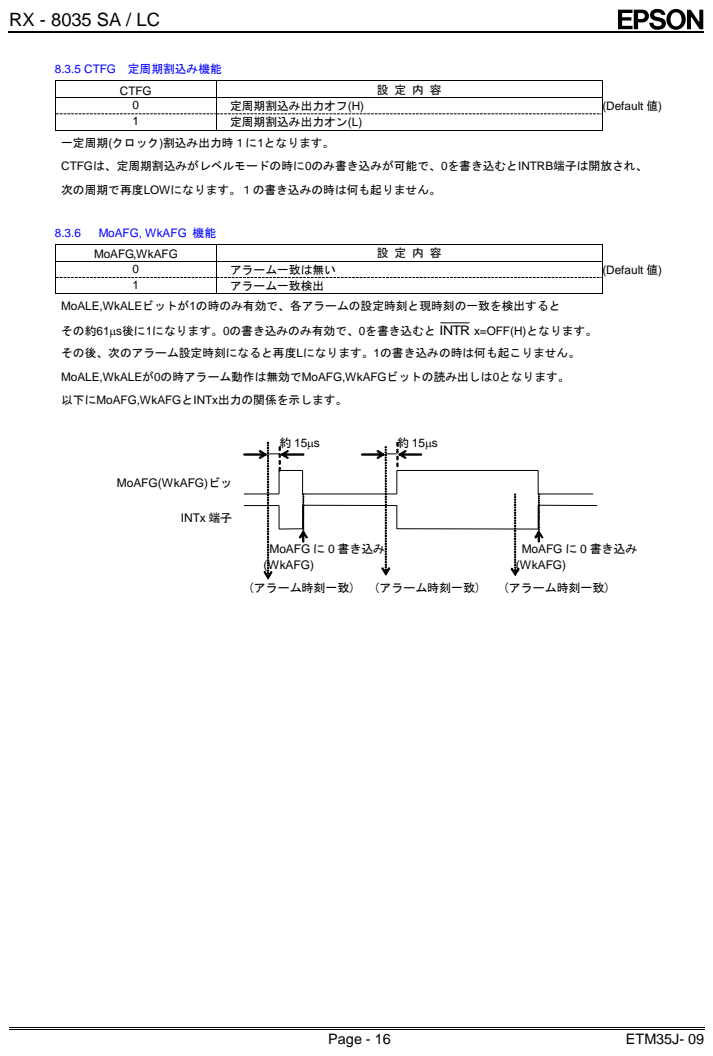
[picture p14: page 20]
Page - 16; ETM35J- 09; 8.3.5 CTFG 定周期割込み機能; CTFG; 定周期割込み出力オフ(H); (Default 値); 定周期割込み出力オン(L); 一定周期(クロック)割込み出力時１に1となります。; CTFGは、定周期割込みがレベルモードの時に0のみ書き込みが可能で、0を書き込むとINTRB端子は開放され、; 次の周期で再度LOWになります。１の書き込みの時は何も起りません。; MoAFG, WkAFG 機能; MoAFG,WkAFG; アラーム一致は無い; アラーム一致検出; MoALE,WkALEビットが1の時のみ有効で、各アラームの設定時刻と現時刻の一致を検出すると; その約61µs後に1になります。0の書き込みのみ有効で、0を書き込むと; INTR; x=OFF(H)となります。; その後、次のアラーム設定時刻になると再度Lになります。1の書き込みの時は何も起こりません。; MoALE,WkALEが0の時アラーム動作は無効でMoAFG,WkAFGビットの読み出しは0となります。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

MoAFG(WkAFG)ビッ

Page - 17 | ETM35J- 09

8.3.7 タイムスタンプレジスタ

(BANK=1,アドレス 0-6h)

Adrs | Function | Data
D7 | D6 | D5 | D4 | D3 | D2 | D1 | D0
0h | タイムスタンプ 秒 | EDCH1 | TS40 | TS20 | TS10 | TS8 | TS4 | TS2 | TS1
1h | タイムスタンプ 分 | EDCH2 | TM40 | TM20 | TM10 | TM8 | TM4 | TM2 | TM1
2h | タイムスタンプ 時 | - | - | TH20 TP/ A | TH10 | TH8 | TH4 | TH2 | TH1
3h | タイムスタンプ 曜 | - | - | - | - | - | TW4 | TW2 | TW1
4h | タイムスタンプ 日 | - | - | TD20 | TD10 | TD8 | TD4 | TD2 | TD1
5h | タイムスタンプ 月 | - | - | - | TMO10 | TMO8 | TMO4 | TMO2 | TMO1
6h | タイムスタンプ 年 | TY80 | TY40 | TY20 | TY10 | TY8 | TY4 | TY2 | TY1
・全てのタイムスタンプレジスタは読み出し専用です。

・EVIN1/2端子からのイベント発生を検出すると最初に発生した日時が記録保持されます。

次のイベントはEDENを再設定しないと記録されません。

・EDENビットに0を書き込むと全てのタイムスタンプレジスタはゼロにクリアされます。

EDCH1,EDCH2 イベント検出時、EVIN1端子 / EVIN2端子判定ビット
EDCH2 | EDCH1 | 設 定 内 容
0 | 0 | EVIN1, EVIN2 端子からのイベント検出なし | (Default 値)
0 | 1 | EVIN1 端子の入力によるイベント検出
1 | 0 | EVIN2 端子の入力によるイベント検出
1 | 1 | EVIN1, EVIN2 両端子(同時)によるイベント検出

EDCH1,EDCH2ビットは、EDEN=1,EDFG=0の状態で、最初にHighとなった端子を記憶します。最初にHigh

となった入力端子がEVIN1の時EDCH1=1、EVIN2の時EDCH2=1になり、EVIN1,EVIN2が同時にHighと

なった場合、EDCH1=EDCH2=1となります。

注：RX-8035LCにはEVIN2端子が有りませんのでEVIN1端子だけがご利用可能です。

このためEDCH2ビットが"1"にセットされることはありません。

8.3.8 Alarm_Wk レジスタ

Alarm_Wk分レジスタ(BANK=0,アドレス8h)
D7 | D6 | D5 | D4 | D3 | D2 | D1 | D0
* | WkM40 | WkM20 | WkM10 | WkM8 | WkM4 | WkM2 | WkM1 | (Write 時)
* | WkM40 | WkM20 | WkM10 | WkM8 | WkM4 | WkM2 | WkM1 | (Read 時)
0 | 0 | 0 | 0 | 0 | 0 | 0 | 0 | Default 値*)

Alarm_Wk時レジスタ(BANK=0,アドレス9h)
D7 | D6 | D5 | D4 | D3 | D2 | D1 | D0
* | * | WkH20 WkP/ A
* | * | WkH20 WkP/ A
| | | WkH10 | WkH8 | WkH4 | WkH2 | WkH1 | (Write 時)
| | | WkH10 | WkH8 | WkH4 | WkH2 | WkH1 | (Read 時)
0 | 0 | 0 | 0 | 0 | 0 | 0 | 0 | Default 値*)

Alarm_Wk曜日レジスタ(BANK=0,アドレスAh)
D7 | D6 | D5 | D4 | D3 | D2 | D1 | D0
* | WkW6 | WkW5 | WkW4 | WkW3 | WkAW2 | WkW1 | WkW0 | (Write 時)
* | WkW6 | WkW5 | WkW4 | WkW3 | WkW2 | WkW1 | WkW0 | (Read 時)
0 | 0 | 0 | 0 | 0 | 0 | 0 | 0 | Default 値*)
*) Default値：0Vからの電源オン後、または電源電圧低下等により、PON=1となった時に自動設定される値です。

･ “ * “印のビットは、0,1の読み出し書き込みが可能です。また、0,1でもアラーム一致には関係ありません。

･ WkALE=0の時、各Alarm_Wkレジスタ(3バイト)はユーザーRAMとして使用可能です。

Page - 18 | ETM35J- 09

･ Alarm_Wk時レジスタD5は、12時間表示時にWkAP/ A

を示します。(AM時0、PM時1)

24時間表示時 にWkH20を示します。(時の10位桁)

･ アラ－ム動作させる場合には、有り得ないアラーム時刻設定のままにしないで下さい。

･ 時桁表示は、12時間表示の時 午前0時→12，午後0時→32となります。

(「■レジスタの機能 ● 12

/24」参照)

･ AW0～AW6は、曜日カウンタ（W4,W2,W1）=（0,0,0）～（1,1,0）に対応します。

･ AW0～AW6が全部0の時、Alarm_Wkは出力されません。

以下にアラ－ム時刻の設定例を示します。
ア ラ ｰ ム 設定時刻 | 曜 日 | 12 時間表示 | 24 時間表示
日 Wk W0 | 月 Wk W1 | 火 Wk W2 | 水 Wk W3 | 木 Wk W4 | 金 Wk W5 | 土 Wk W6 | 10 時 | 1 時 | 10 分 | 1 分 | 10 時 | 1 時 | 1 0 分 | 1 分
毎日 午前 0 時 00 分 | 1 | 1 | 1 | 1 | 1 | 1 | 1 | 1 | 2 | 0 | 0 | 0 | 0 | 0 | 0
毎日 午前 1 時 30 分 | 1 | 1 | 1 | 1 | 1 | 1 | 1 | 0 | 1 | 3 | 0 | 0 | 1 | 3 | 0
毎日 午前 11 時 59 分 | 1 | 1 | 1 | 1 | 1 | 1 | 1 | 1 | 1 | 5 | 9 | 1 | 1 | 5 | 9
月～金 午後 0 時 00 分 | 0 | 1 | 1 | 1 | 1 | 1 | 0 | 3 | 2 | 0 | 0 | 1 | 2 | 0 | 0
日曜 午後 1 時 30 分 | 1 | 0 | 0 | 0 | 0 | 0 | 0 | 2 | 1 | 3 | 0 | 1 | 3 | 3 | 0
月水金 午後 11 時 59 分 | 0 | 1 | 0 | 1 | 0 | 1 | 0 | 3 | 1 | 5 | 9 | 2 | 3 | 5 | 9

上表のWkW0～WkW6と曜日の対応は一例で必ずしもこの通りである必要は有りません。

曜日カウンター値が他の日時カウンター値に影響を与えることは有りません。

8.3.9 Alarm_Mo レジスタ

Alarm_Mo 分レジスタ(BANK=0, アドレスBh)
D7 | D6 | D5 | D4 | D3 | D2 | D1 | D0
* | MoM40 | MoM20 | MoM10 | MoM8 | MoM4 | MoM2 | MoM1 | (Write 時)
* | BM40 | BM20 | BM10 | BM8 | BM4 | BM2 | BM1 | (Read 時)
0 | 0 | 0 | 0 | 0 | 0 | 0 | 0 | Default 値*)

Alarm_Mo 時レジスタ(BANK=0,アドレスCh)
D7 | D6 | D5 | D4 | D3 | D2 | D1 | D0
* | * | MoH20 MoP/ A
* | * | MoH20 MoP/ A
| | | MoH10 | MoH8 | MoH4 | MoH2 | MoH1 | (Write 時)
| | | MoH10 | MoH8 | MoH4 | MoH2 | MoH1 | (Read 時)
0 | 0 | 0 | 0 | 0 | 0 | 0 | 0 | Default 値*)

Alarm_Mo 日レジスタ(BANK=1, アドレスBh)
D7 | D6 | D5 | D4 | D3 | D2 | D1 | D0
DYE | * | MoD20 | MoD10 | MoD8 | MoD4 | MoD2 | MoD1 | (Write 時)
DYE | * | MoD20 | MoD10 | MoD8 | MoD4 | MoD2 | MoD1 | (Read 時)
0 | 0 | 0 | 0 | 0 | 0 | 0 | 0 | Default 値*)

Alarm_Mo 月レジスタ(BANK=1, アドレスCh)
D7 | D6 | D5 | D4 | D3 | D2 | D1 | D0
MOE | * | * | MoMO10 | MoMO8 | MoMO4 | MoMO2 | MoMO1 | (Write 時)
MOE | * | * | MoMO10 | MoMO8 | MoMO4 | MoMO2 | MoMO1 | (Read 時)
0 | 0 | 0 | 0 | 0 | 0 | 0 | 0 | Default 値*)
*) Default値：0Vからの電源オン後、または電源電圧低下等により、PON=1となった時に自動設定される値です。

･ MoALE=0の時、各Alarm_Moレジスタ(4バイト)はユーザーRAMとして使用可能です。

･ Alarm_Mo 時レジスタD5は、12時間表示時にMoP/
A

を示します。(AM時0、PM時1)

24時間表示時 にMoH20を示します。(時の10位桁)

Page - 19 | ETM35J- 09

･ アラ－ム動作させる場合には、有り得ないアラーム時刻設定のままにしないで下さい。

･ 時桁表示は、12時間表示の時 午前0時→12，午後0時→32となります。

(「P.12 ■レジスタの機能 ●制御レジスタ1 (2)12 /24」参照)

･DYEはAlarm_Wkの日データ、MOEはAlarm_Moの月データをそれぞれ有効(データ1)、無効(データ0)にします。無効に設

定したアラームデータはアラーム比較動作の対象外になるため簡略化したアラーム設定が可能になります。

DYE,MOEの値とアラーム一致条件は下表の通りです。

DYE,MOEとアラーム一致条件

MOE | DYE | 内容（MoALE=1:アラーム Mo Enable 時）
0 | 0 | 指定の時・分(1 日に 1 回) | Default 値
0 | 1 | 指定の日・時・分(1 月に 1 回)
1 | 0 | 指定の月で時・分
1 | 1 | 指定の月・日・時・分(1 年に 1 回)

以下にアラ－ム時刻の設定例を示します。

例1）毎年1月1日01時11分

Alarm_Mo レジスタ | ビット | 内容 D7 | D6 | D5 | D4 | D3 | D2 | D1 | D0
分レジスタ | 0 | 0 | 0 | 1 | 0 | 0 | 0 | 1 | 11 分
時レジスタ | 0 | 0 | 0 | 0 | 0 | 0 | 0 | 1 | 1 時
日レジスタ | 1 | 0 | 0 | 0 | 0 | 0 | 0 | 1 | D7=1 で日データ比較
月レジスタ | 1 | 0 | 0 | 0 | 0 | 0 | 0 | 1 | D7=1 で月データ比較

例2）毎月1日01時11分

Alarm_Mo レジスタ | ビット | 内容 D7 | D6 | D5 | D4 | D3 | D2 | D1 | D0
分レジスタ | 0 | 0 | 0 | 1 | 0 | 0 | 0 | 1 | 11 分
時レジスタ | 0 | 0 | 0 | 0 | 0 | 0 | 0 | 1 | 1 時
日レジスタ | 1 | 0 | 0 | 0 | 0 | 0 | 0 | 1 | D7=1 で日データ比較
月レジスタ | 0 | x | x | x | x | x | x | x | D7=0 のため 月データ比較せず

例3）毎日01時11分

Alarm_Mo レジスタ | ビット | 内容 D7 | D6 | D5 | D4 | D3 | D2 | D1 | D0
分レジスタ | 0 | 0 | 0 | 1 | 0 | 0 | 0 | 1 | 11 分
時レジスタ | 0 | 0 | 0 | 0 | 0 | 0 | 0 | 1 | 1 時
日レジスタ | 0 | x | x | x | x | x | x | x | D7=0 のため 日データ比較せず
月レジスタ | 0 | x | x | x | x | x | x | x | D7=0 のため 月データ比較せず

8.3.10 ユーザーRAM

(BANK=0,1 アドレス Dh)

D7 | D6 | D5 | D4 | D3 | D2 | D1 | D0
* | * | * | * | * | * | * | * | (Write 時)
* | * | * | * | * | * | * | * | (Read 時)
0 | 0 | 0 | 0 | 0 | 0 | 0 | 0 | Default 値 *)
*) Default値：0Vからの電源オン後、または電源電圧低下等により、PON=1となった時に自動設定される値です。

Page - 20 | ETM35J- 09

8.3.11 時計カウンタ

秒カウンタ(アドレス0h)
D7 | D6 | D5 | D4 | D3 | D2 | D1 | D0
－ | S40 | S20 | S10 | S8 | S4 | S2 | S1 | (Write 時)
0 | S40 | S20 | S10 | S8 | S4 | S2 | S1 | (Read 時)
0 | 不定 | 不定 | 不定 | 不定 | 不定 | 不定 | 不定 | Default 値 *)
分カウンタ(アドレス1h)
D7 | D6 | D5 | D4 | D3 | D2 | D1 | D0
－ | M40 | M20 | M10 | M8 | M4 | M2 | M1 | (Write 時)
0 | M40 | M20 | M10 | M8 | M4 | M2 | M1 | (Read 時)
0 | 不定 | 不定 | 不定 | 不定 | 不定 | 不定 | 不定 | Default 値 *)
時カウンタ(アドレス2h)
D7 | D6 | D5 | D4 | D3 | D2 | D1 | D0
12/24 | － | P/ A or H20
12/24 | 0 | P/ A or H20
| | | H10 | H8 | H4 | H2 | H1 | (Write 時)
| | | H10 | H8 | H4 | H2 | H1 | (Read 時)
不定 | 0 | 不定 | 不定 | 不定 | 不定 | 不定 | 不定 | Default 値 *)
*) Default値：0Vからの電源オン後、または電源電圧低下等により、PON=1となった時に自動設定される値です。

･ 桁表示(BCDコ－ド) 秒 00～59 で 59 → 00の時、分桁へ桁上げされます

分 00～59 で 59 → 00の時、時桁へ桁上げされます

時
| | | 12

/24ビット参照

･ 秒カウンタに書き込みを行うと1秒未満の内部カウントはリセットされます。

･ 秒カウンタにデータ書き込み後は、その都度VDETフラグビットをリセット（ゼロクリア）してください。

･ 非存在日時データを設定しないでください。（30時,70分, 33日, 0月,など））

非存在日時状態での時計カウンタ更新値は予測困難で誤動作の原因にもなります。 うるう秒調整に用いられる60秒の書き込みには非対応です。

/24 12時間制/24時間制選択ビット

12/24 | 設 定 内 容
0 | 午前、午後を表示する 12 時間制計時 | (Default 値)
1 | 24 時間制計時
このビットが0の時、12時間表示、1の時、24時間表示になる。時間桁表示表を以下に示します。
24 時間制 | 12 時間制 | 24 時間制 | 12 時間制
00 01 02 03 04 05 06 07 08 09 10 11 | 12 (AM12) 01 (AM 1) 02 (AM 2) 03 (AM 3) 04 (AM 4) 05 (AM 5) 06 (AM 6) 07 (AM 7) 08 (AM 8) 09 (AM 9) 10 (AM10) 11 (AM11) | 12 13 14 15 16 17 18 19 20 21 22 23 | 32 (PM12) 21 (PM 1) 22 (PM 2) 23 (PM 3) 24 (PM 4) 25 (PM 5) 26 (PM 6) 27 (PM 7) 28 (PM 8) 29 (PM 9) 30 (PM10) 31 (PM11)

12時間･24時間の設定は時刻Dataの書き込み前に行って下さい。

Page - 21 | ETM35J- 09

8.3.12 曜日カウンタ

(BANK=0 アドレス 3h)

D7 | D6 | D5 | D4 | D3 | D2 | D1 | D0
－ | － | － | － | － | W4 | W2 | W1 | (Write 時)
0 | 0 | 0 | 0 | 0 | W4 | W2 | W1 | (Read 時)
0 | 0 | 0 | 0 | 0 | 不定 | 不定 | 不定 | Default 値 *)
*) Default値：0Vからの電源オン後、または電源電圧低下等により、PON=1となった時に自動設定される値です。

･ 日桁への桁上げ時にプラス１されます。

･ 曜日表示（7進アップカウント） (W4W2W1)＝(000)→(001)→･････→(110)→(000)

･ 曜日とカウント値の対応は、ユ－ザ－にて自由に設定。（例 日曜日＝000など）

･ 曜日を使用しない場合を除いて、(W4W2W1)＝(111)は書き込まないで下さい。

8.3.13 カレンダカウンタ

(BANK=0 アドレス 4-6h)
日カウンタ(アドレス4h)
D7 | D6 | D5 | D4 | D3 | D2 | D1 | D0
－ | － | D20 | D10 | D8 | D4 | D2 | D1 | (Write 時)
0 | 0 | D20 | D10 | D8 | D4 | D2 | D1 | (Read 時)
0 | 0 | 不定 | 不定 | 不定 | 不定 | 不定 | 不定 | Default 値 *)
月カウンタ(アドレス5h)
D7 | D6 | D5 | D4 | D3 | D2 | D1 | D0
－ | － | － | MO10 | MO8 | MO4 | MO2 | MO1 | (Write 時)
0 | 0 | 0 | MO10 | MO8 | MO4 | MO2 | MO1 | (Read 時)
0 | 0 | 0 | 不定 | 不定 | 不定 | 不定 | 不定 | Default 値 *)
年桁レジスタ(アドレス6h)
D7 | D6 | D5 | D4 | D3 | D2 | D1 | D0
Y80 | Y40 | Y20 | Y10 | Y8 | Y4 | Y2 | Y1 | (Write 時)
Y80 | Y40 | Y20 | Y10 | Y8 | Y4 | Y2 | Y1 | (Read 時)
不定 | 不定 | 不定 | 不定 | 不定 | 不定 | 不定 | 不定 | Default 値 *)
*) Default値：0Vからの電源オン後、または電源電圧低下等により、PON=1となった時に自動設定される

値です。

･ オ－トカレンダ－機能により、桁表示（BCDコ－ド）は、

日桁(D20-D1) | 1～31（1,3,5,7,8,10,12月）

1～30（4,6,9,11月）

1～29（2月 うるう年）

1～28（2月 通常年）

カウント値が1に戻る時に月桁へ桁上げされます

月桁(MO10-MO1) | 1～12で、カウント値が1に戻る時に年桁へ桁上げされます
年桁(Y80-Y1) | 00～99で、00,04,08,･････,92,96がうるう年として2月を29日までカウントします。

西暦の100年毎、すなわち西暦の下2桁が00年は閏年ではありません。

また、西暦で400の倍数年は閏年です。（1600年、2000年、2400年）

･ 非存在日時データを設定しないでください。（30時,70分, 33日, 0月,など））

非存在日時状態での時計カウンタ更新値は予測困難で誤動作の原因にもなります。

Page - 22 | ETM35J- 09
8.4. 時計精度調整機能
RTC の内蔵時計を進み側に調整、または遅れ側に調整することができます。 この機能を応用してご使用される温度環境に最適な調整を行うことでより高精度な時刻計時が可能です。 * 時計精度調整機能によって CLKOUT 端子の 32.768 kHz 出力周波数精度は影響を受けません。
8.4.1. 関連レジスタ
Address | Function | bit 7 | bit 6 | bit 5 | bit 4 | bit 3 | bit 2 | bit 1 | bit 0
7 | Digital Offset ( Default ) | 0 ( 0 ) | F6 ( 0 ) | F5 ( 0 ) | F4 ( 0 ) | F3 ( 0 ) | F2 ( 0 ) | F1 ( 0 ) | F0 ( 0 )

* ) bit7 は R/W 可能ですが､ 必ずゼロを設定して使用してください。

- F6 ~ F0 の 7 bit の符号化 2 進数の設定により､ 32768 Hz の内部水晶発振回路より作成している時計/時計精度を､ ± 3.05 × 10-6 単位で 最大±189.1 × 10-6 まで進ませる あるいは 遅らせることができます。

*1) 本機能を使用しない場合は､ F6 ~ F0 の全てを " 0 " にしてください。
*2) 本機能は 20秒に1回ごと ( 00秒, 20秒, 40秒) に動作しますので､ そのタイミングで発生する定周期割り込みの 周期は変化します。( [ 項8.4. 定周期割り込み機能 ] を参照してください )
8.4.2. 調整量
1) 調整範囲 と 分解能
調整範囲 | 調整分解能 | 内部での調整実施タイミング
-189.1 × 10-6 ~ +189.1 × 10-6 | ± 3.05 × 10-6 | 20 秒毎に 1 回 ( 00 秒, 20 秒, 40 秒のとき)
2) 調整量 と 調整値
調整量 ( × 10-6 ) | 調整データ 10 進 / 16 進 | bit 7 0 | bit 6 F6 | bit 5 F5 | bit 4 F4 | bit 3 F3 | bit 2 F2 | bit 1 F1 | bit 0 F0
-189.10 | +63 / 3F h | 0 | 0 | 1 | 1 | 1 | 1 | 1 | 1
-186.05 | +62 / 3E h | 0 | 0 | 1 | 1 | 1 | 1 | 1 | 0
-183.00 | +61 / 3D h | 0 | 0 | 1 | 1 | 1 | 1 | 0 | 1
- • • | • • • | • • •
-9.15 | +4 / 04 | 0 | 0 | 0 | 0 | 0 | 1 | 0 | 0
-6.10 | +3 / 03 | 0 | 0 | 0 | 0 | 0 | 0 | 1 | 1
-3.05 | +2 / 02 h | 0 | 0 | 0 | 0 | 0 | 0 | 1 | 0
OFF | 1 / 01 h | 0 | 0 | 0 | 0 | 0 | 0 | 0 | 1
OFF | 0 / 00 h | 0 | 0 | 0 | 0 | 0 | 0 | 0 | 0
+3.05 | -1 / 7F h | 0 | 1 | 1 | 1 | 1 | 1 | 1 | 1
+6.10 | -2 / 7E h | 0 | 1 | 1 | 1 | 1 | 1 | 1 | 0
+9.15 | -3 / 7D h | 0 | 1 | 1 | 1 | 1 | 1 | 0 | 1
- • • | • • • | • • •
+183.00 | -60 / 44 h | 0 | 1 | 0 | 0 | 0 | 1 | 0 | 0
+186.05 | -61 / 43 h | 0 | 1 | 0 | 0 | 0 | 0 | 1 | 1
+189.10 | -62 / 42 h | 0 | 1 | 0 | 0 | 0 | 0 | 1 | 0
OFF | -63 / 41 h | 0 | 1 | 0 | 0 | 0 | 0 | 0 | 1
OFF | -64 / 40 h | 0 | 1 | 0 | 0 | 0 | 0 | 0 | 0

Page - 23 | ETM35J- 09
8.4.3. 調整例
CLKOUT 端子から出力される内蔵水晶発振周波数は 32768Hz が時計誤差ゼロになります。

例 1) 時計を進み側に調整する場合。

例 ) CLKOUT クロック出力が 32767.7 Hz のときの時計精度誤差を調整する( 進み側に調整 )。

(1) 現在のズレ量を把握する。

32767.7 Hz → ( 32767.7 - 32768 ) / 32768
→ -9.16 × 10-6
(2) 現在のズレ量に対する最適調整データ(10 進数)を算出する。

調整データ = ズレ量 / 調整分解能
= -9.16 / 3.05
≈ -3 (小数点以下を四捨五入する)

* 遅れを進めるには逆数で補正すれば良いことになりますが､ 本機種では調整の +/-の関係を逆にしてありますので そのまま上記の計算式により算出します。

(3) 設定調整データ( 16 進数 )を算出する

7 bit の符号化 2 進数を考慮したうえで 設定調整データを算出するには､ 128(80h)から調整データ(10 進数)を引き算します。

設定調整データ = 128 - 3 = 125 ( 10 進数 )
= 80 h - 03 h = 7D h ( 16 進数 )

例 2) 時計を遅れ側に調整する場合。

例題) CLKOUT クロック出力が 32768.3 Hz のときの時計精度誤差を調整する( 遅れ側に調整 )。

(1) 現在のズレ量を把握する。

32768.3 Hz → ( 32768.3 - 32768 ) / 32768
→ +9.16 × 10-6
(2) 現在のズレ量に対する最適調整データ(10 進数)を算出する。

調整データ = ( ズレ量 / 調整分解能 ) + 1
= ( +9.16 / 3.05 ) + 1 | * 基準が 01h のため､ +1 する
≈ +4 (小数点以下を四捨五入する)

* 進めを遅らせるには逆数で補正すれば良いことになりますが､ 本機種では調整の +/-の関係を逆にしてありますので そのまま上記の計算式により算出します。

(3) 設定調整データ( 16 進数 )を算出する

4 を､ そのまま 16 進数化します。

設定調整データ = 04 h ( 16進数 )

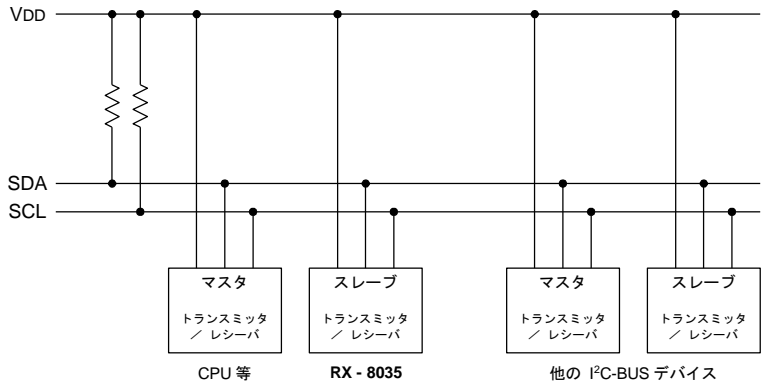
[picture p15: figure]
マスタ; トランスミッタ ／ レシーバ; スレーブ; 他の I CPU 等; 2C-BUS デバイス; SDA SCL; VDD

Page - 24 | ETM35J- 09
8.5. データのリード/ライト

8.5.1 I2C-BUS の通信手順

I

2C-BUS は､ SDA ( データライン ) と SCL ( クロックライン ) とで構成される 2 線式の双方向通信です。

この 2 つの信号の組み合わせにより､ 通信の開始 / 停止 / データ転送 / アクノリッジ等の送受信を行います。

非通信時は SCL, SDA ともに High に保ちます。

通信の開始と停止は､ SCL が High で､かつ､SDA を立ち上げる または 立ち下げることで制御します。

データの転送は､ 送信時の SDA ライン上のデータ変更は SCL ラインが LOW の区間で行い､ また､ 受信側では

SCL ラインが HIGH の区間でデータを取り込みます。 どちらの場合も､ SCL ラインの 1 クロックパルスごとに

1 ビットずつ行います。

I

2C-BUS デバイスは 通常のロジックデバイスが有するチップセレクト端子を持ちません。 チップセレクトの

代用として 各デバイスにはスレーブアドレスが割り当てられており､ 受信デバイスは 受信したスレーブアドレスが

一致した場合にのみ､ その後の通信に反応します。

システム構成

I

2C-BUS に接続する全てのポートは､ 複数のデバイスの AND 接続を実現するためにオープンドレイン あるいは

オープンコレクタでなければなりません。 SCL, SDA は､ともにプルアップ抵抗を介してシステム電源ラインに

接続し､ BUS 開放時(非通信時)は SCL, SDA ともに High にします。

データの送受信を制御するデバイスを " マスタ "､ マスタによって制御されるデバイスを " スレーブ " と定義します。

また､ データを送信するデバイスを " トランスミッタ "､ データを受信するデバイスを " レシーバ " とします。

本 RTC の場合､ CPU 等のコントローラがマスタ､ 本 RTC がスレーブとなります。 データの送信/受信は

どちらも行いますので､ 状況によりトランスミッタになり また レシーバにもなります。

内蔵水晶の発振が必要です
RX-8035 は内蔵水晶の発振スタートによって、I2C インターフェースを動作可能にします。 水晶発振が停止中に I2C-BUS アクセスを行った場合はアクノリッジが出力されず、正常なアクセスが 行なわれませんのでご注意ください。

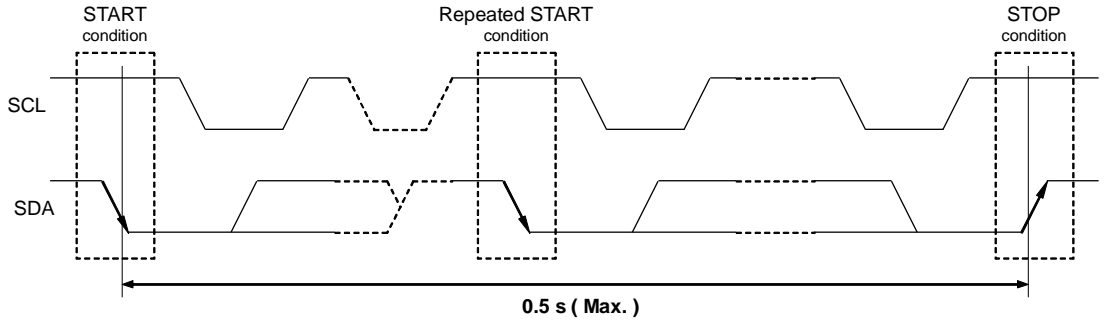
[picture p16: figure]
SCL; START condition; SDA; 0.5 s ( Max. ); Repeated START condition; STOP condition

Page - 25 | ETM35J- 09

I2C-BUS通信の 開始と停止

1) START condition / Repeated START condition と STOP condition
(1) START condition ( 開始条件 )
- I

2C-BUS 通信を開始するための規定条件です。

SCL が High の状態で かつ SDA を High から Low に変化させます。

(2) STOP condition ( 停止条件 )
- I

2C-BUS 通信を正常終了させるための規定条件です。

SCL が High の状態で かつ SDA を Low から High に変化させます。

(3) Repeated START condition / Re-START condition ( 再送開始条件 )
- START condition と STOP condition の途中で､ 再度 START condition と同じ状態にする場合があり､

それを Re-START condition ( 再送開始条件 ) として区別します。 必要な状態は START condition と

同じですから､ SCL が High の状態で かつ SDA を High から Low に変化させます。

2) 注意事項
*1) | 通信の START, Re-START condition と STOP condition の制御は､ 常にマスタが行います。
*2) | マスタによる STOP condition 送信の実施タイミングに制限はありませんので､ 通信の途中であっても 強制的に通信を終了させることができます。 (ただし､ 本 RTC がレシーバ状態 ( データ受信状態 = SDA 開放状態 ) のときに限ります。)
*3) | 本 RTC との通信は､ START condition 送信から STOP condition 送信までの一連の通信を 0.5 秒以内に 終了させてください。 ( START condition と STOP condition の間に Re-START condition を送る場合がありますが､ その場合でも､ START condition から STOP condition までを 0.5 秒以内に終了させてください ) 0.5 秒 ~ 1 秒以上の時間がかかった場合､ 本 RTC 内の BUS タイムアウト機能によって I 2C-BUS インタフェースは自動解除されて待機状態になります。 自動解除時 および その後の通信は､ 書き込み / 読み出し ともに無効となりますので ご注意ください。 ( 読み出し無効時は､ 読み出される全てのデータが " 1 " になります ) 通信を再開するには､ 再度､ START condition の送信から始めます。
*4) | 本 RTC との通信では､ 通信停止の STOP condition 送信から 次の通信を始める START condition 送信 までを 62 µs 以上空けてください。 ( 通信の間に計時データの桁上げが発生した場合は､ この間に補正しています )

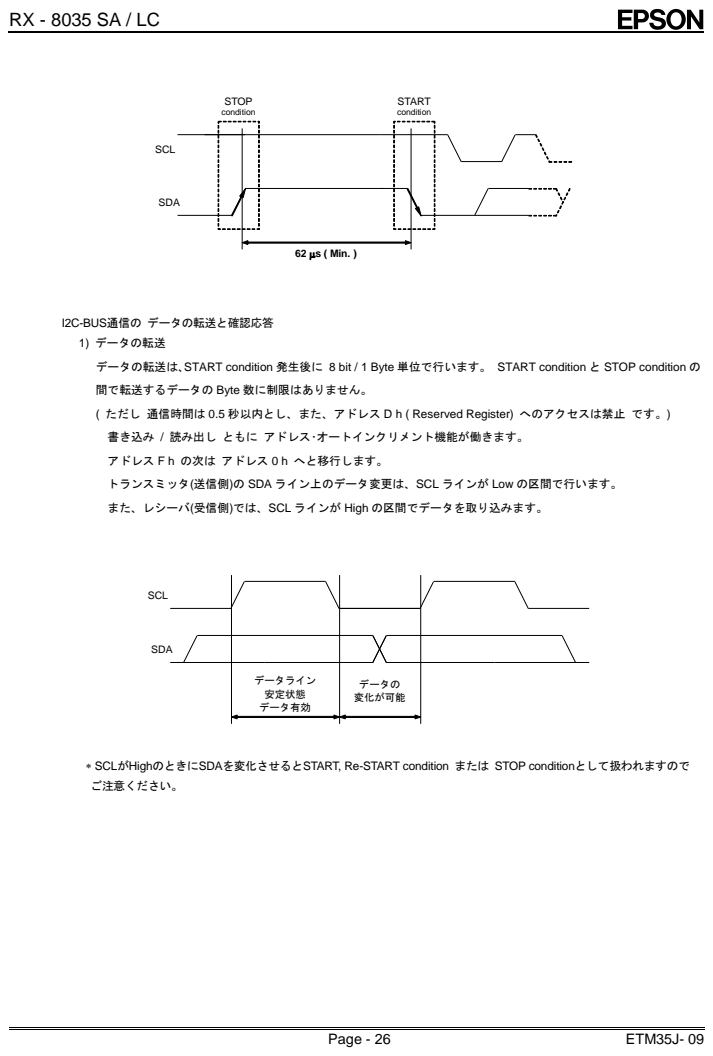
[picture p17: page 30]
Page - 26; ETM35J- 09; I2C-BUS通信の データの転送と確認応答; 1) データの転送; SCL; SDA; 62 µs ( Min. ); STOP condition; START condition SCL; データライン 安定状態 データ有効; データの 変化が可能

データの転送は､START condition 発生後に 8 bit / 1 Byte 単位で行います。 START condition と STOP condition の

間で転送するデータの Byte 数に制限はありません。

( ただし 通信時間は 0.5 秒以内とし､ また､ アドレス D h ( Reserved Register) へのアクセスは禁止 です。)

書き込み / 読み出し ともに アドレス･オートインクリメント機能が働きます。

アドレス F h の次は アドレス 0 h へと移行します。

トランスミッタ(送信側)の SDA ライン上のデータ変更は､ SCL ラインが Low の区間で行います。

また､ レシーバ(受信側)では､ SCL ラインが High の区間でデータを取り込みます。

* SCLがHighのときにSDAを変化させるとSTART, Re-START condition または STOP conditionとして扱われますので
ご注意ください。

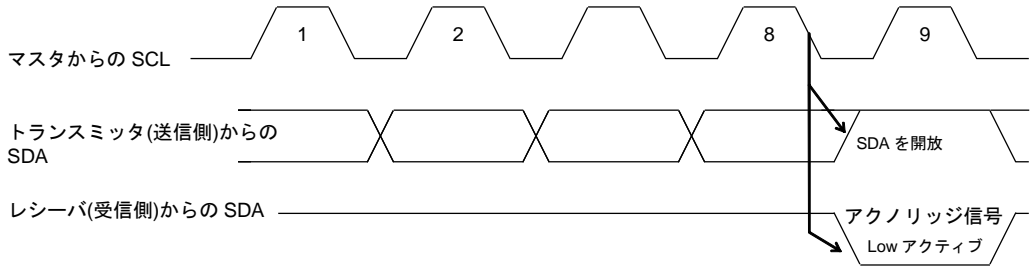
[picture p18: figure]
マスタからの SCL; トランスミッタ(送信側)からの SDA; アクノリッジ信号; レシーバ(受信側)からの SDA; SDA を開放; Low アクティブ

Page - 27 | ETM35J- 09
2) データの確認応答 ( アクノリッジ信号 )

データの転送時､ レシーバは 8 bit のデータを受信するたびに 確認応答 = アクノリッジ信号( Low アクティブ ) を

生成します。

レシーバからのアクノリッジが無い場合は､ その通信は正しく行われなかったことを意味します。

( ただし､ マスタによる 意図的なアクリッジの非生成を除く )

データ転送の SCL の 8 bit 目のクロックパルスが Low に立ち下がった直後､ トランスミッタは SDA を解放し､ また､ レシーバは SDA を Low ( = アクノリッジ ) にします。

レシーバがアクノリッジ信号送出後､ 次の 1 Byte 転送も そのままレシーバであるときは SCL の 9 bit 目のクロックの 立ち下がりで SDA を解放します。 また､ トランスミッタになるときは データの転送に移ります。 マスタがレシーバになっている場合､ マスタはスレーブから送信された最後の 1 Byte に対するアクノリッジを 生成しないことで､ トランスミッタにデータ転送の終了を知らせます。
このとき トランスミッタは､ そのまま SDA を放し続けて マスタによる STOP condition の発生に備えます。

8.5.2 スレーブアドレス

I

2C-BUS デバイスは 通常のロジックデバイスが有するチップセレクト端子を持ちません。

チップセレクトの代用として 各デバイスにはスレーブアドレスが割り当てられています。

全ての通信は [ START condition ] + [ スレーブアドレス ( + R/W 指定 ) ] の送信から始まります。 受信デバイスは､

受信した指定スレーブアドレスが 自己のスレーブアドレスと一致した場合にのみ､ その後の通信に反応します。

スレーブアドレスは 7 bit の固定値で､ 本 RTC では [ 0110 010* ] です。

スレーブアドレスは 7 bit ですが､ 通信時には R/W bit を付加した 8 bit を転送します。

| 転送データ | スレーブアドレス | R / W bit
bit 7 | bit 6 | bit 5 | bit 4 | bit 3 | bit 2 | bit 1 | bit 0
Read 時 | 65 h | 0 | 1 | 1 | 0 | 0 | 1 | 0 | 1 ( = Read )
Write 時 | 64 h | | | | | | | | 0 ( = Write )

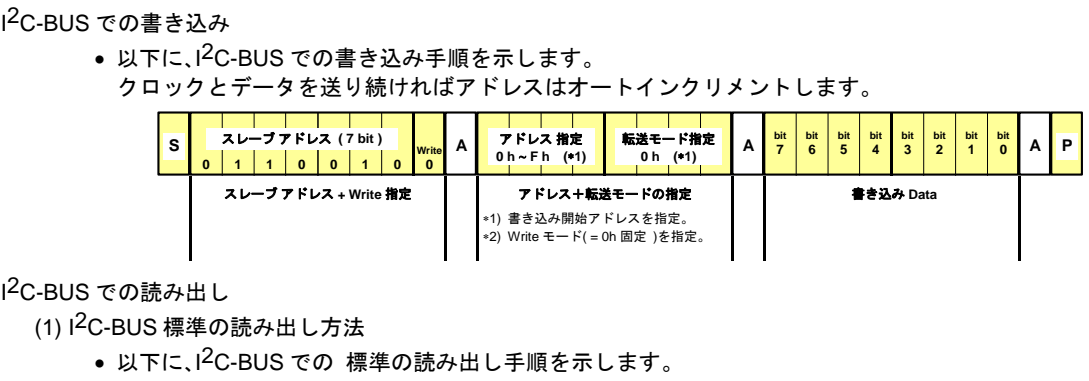
[picture p19: figure]
2C-BUS での書き込み; • 以下に､I; 2C-BUS での書き込み手順を示します。 クロックとデータを送り続ければアドレスはオートインクリメントします。; bit 7; bit 6; bit 5; bit 4; bit 3; bit 2; bit 1; bit S; スレーブ アドレス + Write 指定; アドレス 指定; 転送モード指定; アドレス＋転送モードの指定; *1) 書き込み開始アドレスを指定。 *2) Write モード( = 0h 固定 )を指定。; Write 0; スレーブ アドレス ( 7 bit ); 書き込み Data; 2C-BUS での読み出し; 2C-BUS 標準の読み出し方法; 2C-BUS での 標準の読み出し手順を示します。
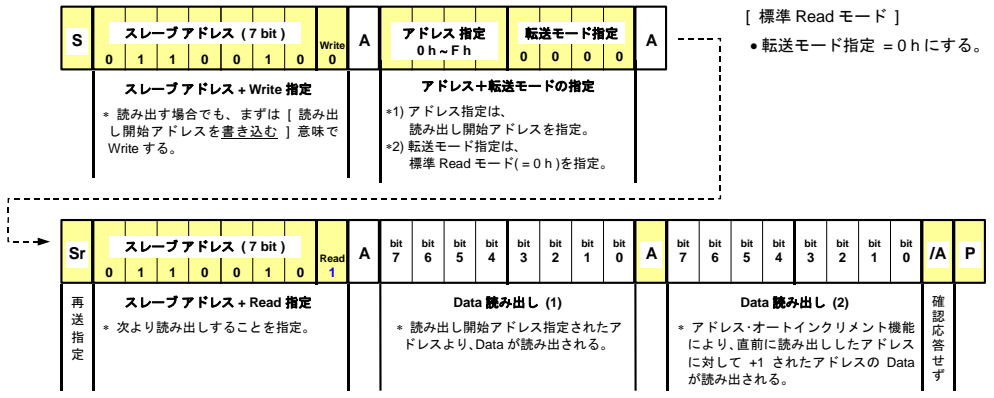
[picture p20: figure]
スレーブ アドレス + Write 指定; * 読み出す場合でも､ まずは [ 読み出 し開始アドレスを書き込む ] 意味で Write する。; Write 0; スレーブ アドレス ( 7 bit ); スレーブ アドレス + Read 指定; * 次より読み出しすることを指定。; Read 1; bit 7; bit 6; bit 5; bit 4; bit 3; bit 2; bit 1; bit 0; Data 読み出し (2); * アドレス･オートインクリメント機能 により､直前に読み出ししたアドレス に対して +1 されたアドレスの Data が読み出される。; Data 読み出し (1); * 読み出し開始アドレス指定されたア ドレスより､Data が読み出される。; [ 標準 Read モード ]; • 転送モード指定 = 0 h にする。 0; アドレス 指定; 転送モード指定; アドレス＋転送モードの指定; *1) アドレス指定は､ 読み出し開始アドレスを指定。 *2) 転送モード指定は､ 標準 Read モード( = 0 h )を指定。
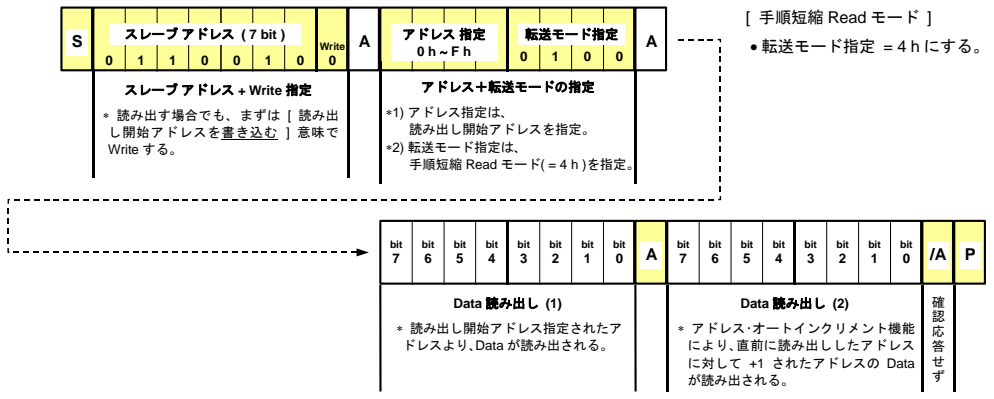
[picture p21: figure]
bit 7; bit 6; bit 5; bit 4; bit 3; bit 2; bit 1; bit 0; スレーブ アドレス + Write 指定; * 読み出す場合でも､ まずは [ 読み出 し開始アドレスを書き込む ] 意味で Write する。; アドレス 指定; 転送モード指定; アドレス＋転送モードの指定; *1) アドレス指定は､ 読み出し開始アドレスを指定。 *2) 転送モード指定は､ 手順短縮 Read モード( = 4 h )を指定。; Write 0; スレーブ アドレス ( 7 bit ); Data 読み出し (2); * アドレス･オートインクリメント機能 により､直前に読み出ししたアドレス に対して +1 されたアドレスの Data が読み出される。; [ 手順短縮 Read モード ]; • 転送モード指定 = 4 h にする。; Data 読み出し (1); * 読み出し開始アドレス指定されたア ドレスより､Data が読み出される。
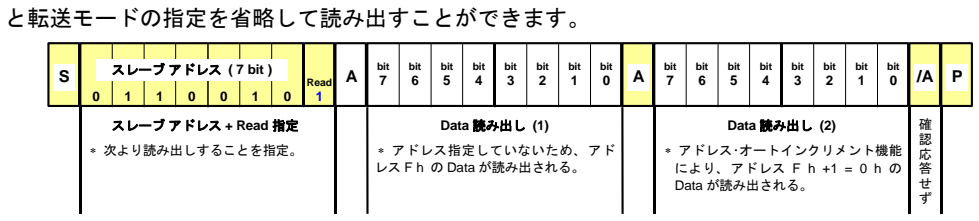
[picture p22: figure]
と転送モードの指定を省略して読み出すことができます。; スレーブ アドレス + Read 指定; * 次より読み出しすることを指定。; Read 1; スレーブ アドレス ( 7 bit ); bit; bit 6; bit 5; bit 4; bit 3; bit 2; bit 1; bit 0; bit 7; Data 読み出し (2); * アドレス･オートインクリメント機能 により､ アドレス F h +1 = 0 h の Data が読み出される。; Data 読み出し (1); * アドレス指定していないため､ アド レス F h の Data が読み出される。

Page - 28 | ETM35J- 09

8.5.3 I2C-BUS の基本転送フォーマット
- 書き込み / 読み出し の手順は 次のとおりです。

マスタがトランスミッタ(送信側)､
RTC がレシーバ(受信側)

マスタがレシーバ(受信側)､
RTC がトランスミッタ(送信側)

S

マスタが送信する
START condition

Sr

マスタが送信する
Re-START condition

P

マスタが送信する
STOP condition

A

マスタによる
確認応答の実施

A

RTC からの
確認応答あり

/A

マスタは
確認応答せず
1) I
2) I
(2) 便利な読み出し方法
- 本 RTC では､ 読み出し手順を短縮できる 特別な読み出し方法があります。
(3) アドレス F h からの､ 読み出し開始アドレスを指定しない読み出し方法
- アドレス F h → 0 h → 1 h → 2 h … のように アドレス F h から読み出す場合にのみ､ 読み出しアドレス

* 上記手順は 1 ~ 2Btype 通信の例ですが､ 実際の通信においては 通信する Byte 数に制限はありません。 ( ただし､ 通信時間は 0.5 秒以内に完了してください。)

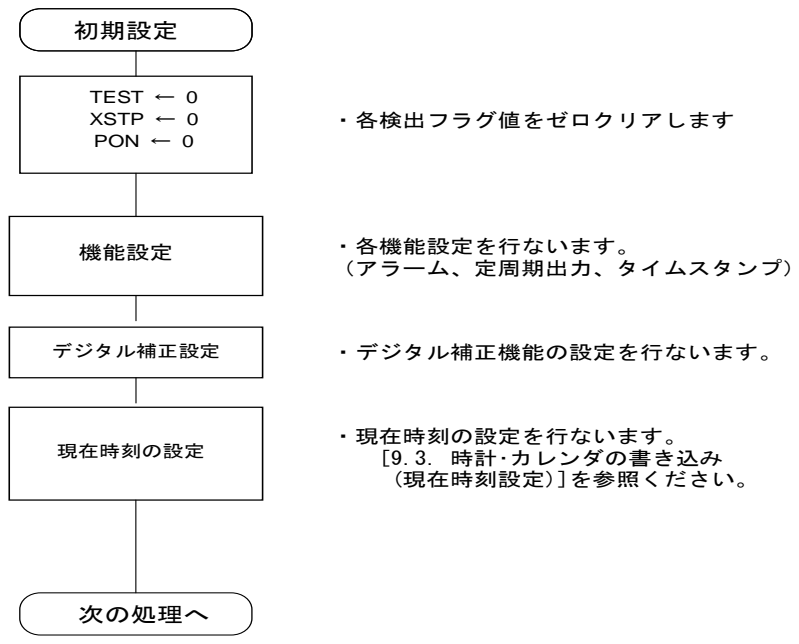
[picture p23: figure]
・各検出フラグ値をゼロクリアします; ・各機能設定を行ないます。 （アラーム、定周期出力、タイムスタンプ）; ・デジタル補正機能の設定を行ないます。; ・現在時刻の設定を行ないます。 [9.3. 時計･カレンダの書き込み (現在時刻設定)]を参照ください。; 次の処理へ; 初期設定; デジタル補正設定; TEST ← 0 XSTP ← 0 PON ← 0; 機能設定; 現在時刻の設定

Page - 29 | ETM35J- 09

## 9 フローチャート

9.1. 初期電源投入時の手続き (初期設定)
9.1.1. 初期設定

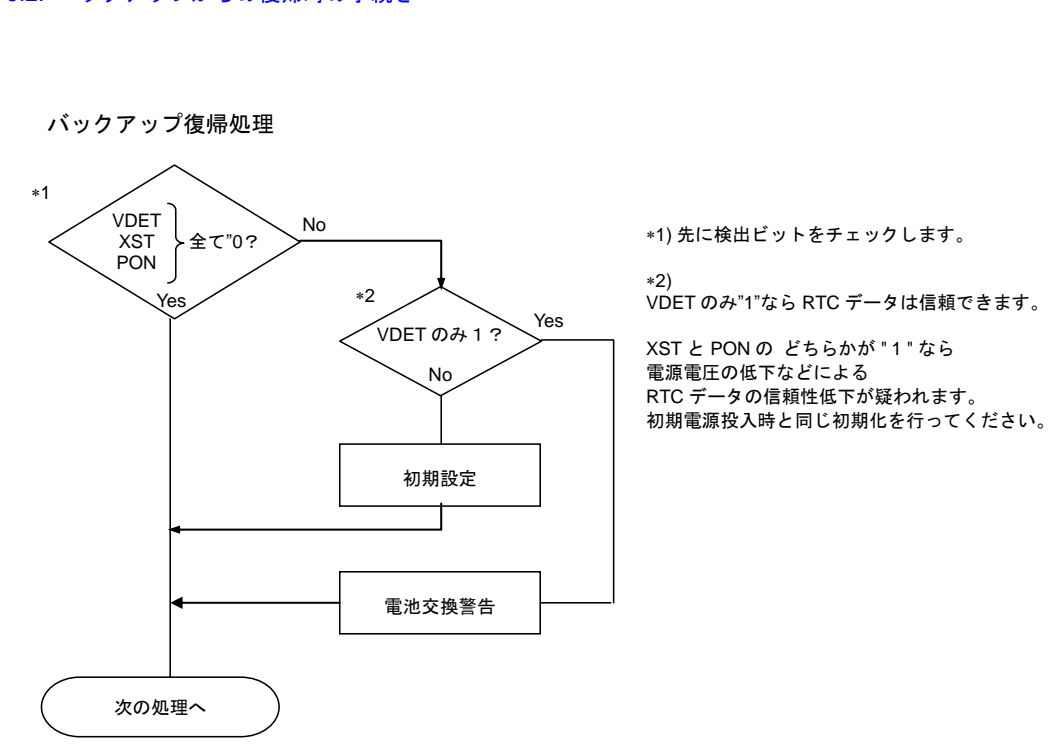
[picture p24: figure]
*1) 先に検出ビットをチェックします。; *2) VDET のみ”1”なら RTC データは信頼できます。; XST と PON の どちらかが " 1 " なら 電源電圧の低下などによる RTC データの信頼性低下が疑われます。 初期電源投入時と同じ初期化を行ってください。; 次の処理へ; バックアップ復帰処理; Yes; VDET XST PON; 初期設定; VDET のみ１？; 電池交換警告

Page - 30 | ETM35J- 09
9.2. バックアップからの復帰時の手続き
9. 3. 時計･カレンダの書き込み (現在時刻設定)

VDET を確認される場合は
時刻設定の前に読み出してください。

・計時、カレンダレジスタへのデータ設定を行ないます。

・時刻設定後に VDET フラグをゼロクリアしてください。

### 現在時刻設定

計時･カレンダ
レジスタへの
データ設定

Bank 0

VDET ← 0

Return

VDET の確認

## 10. 外部接続例

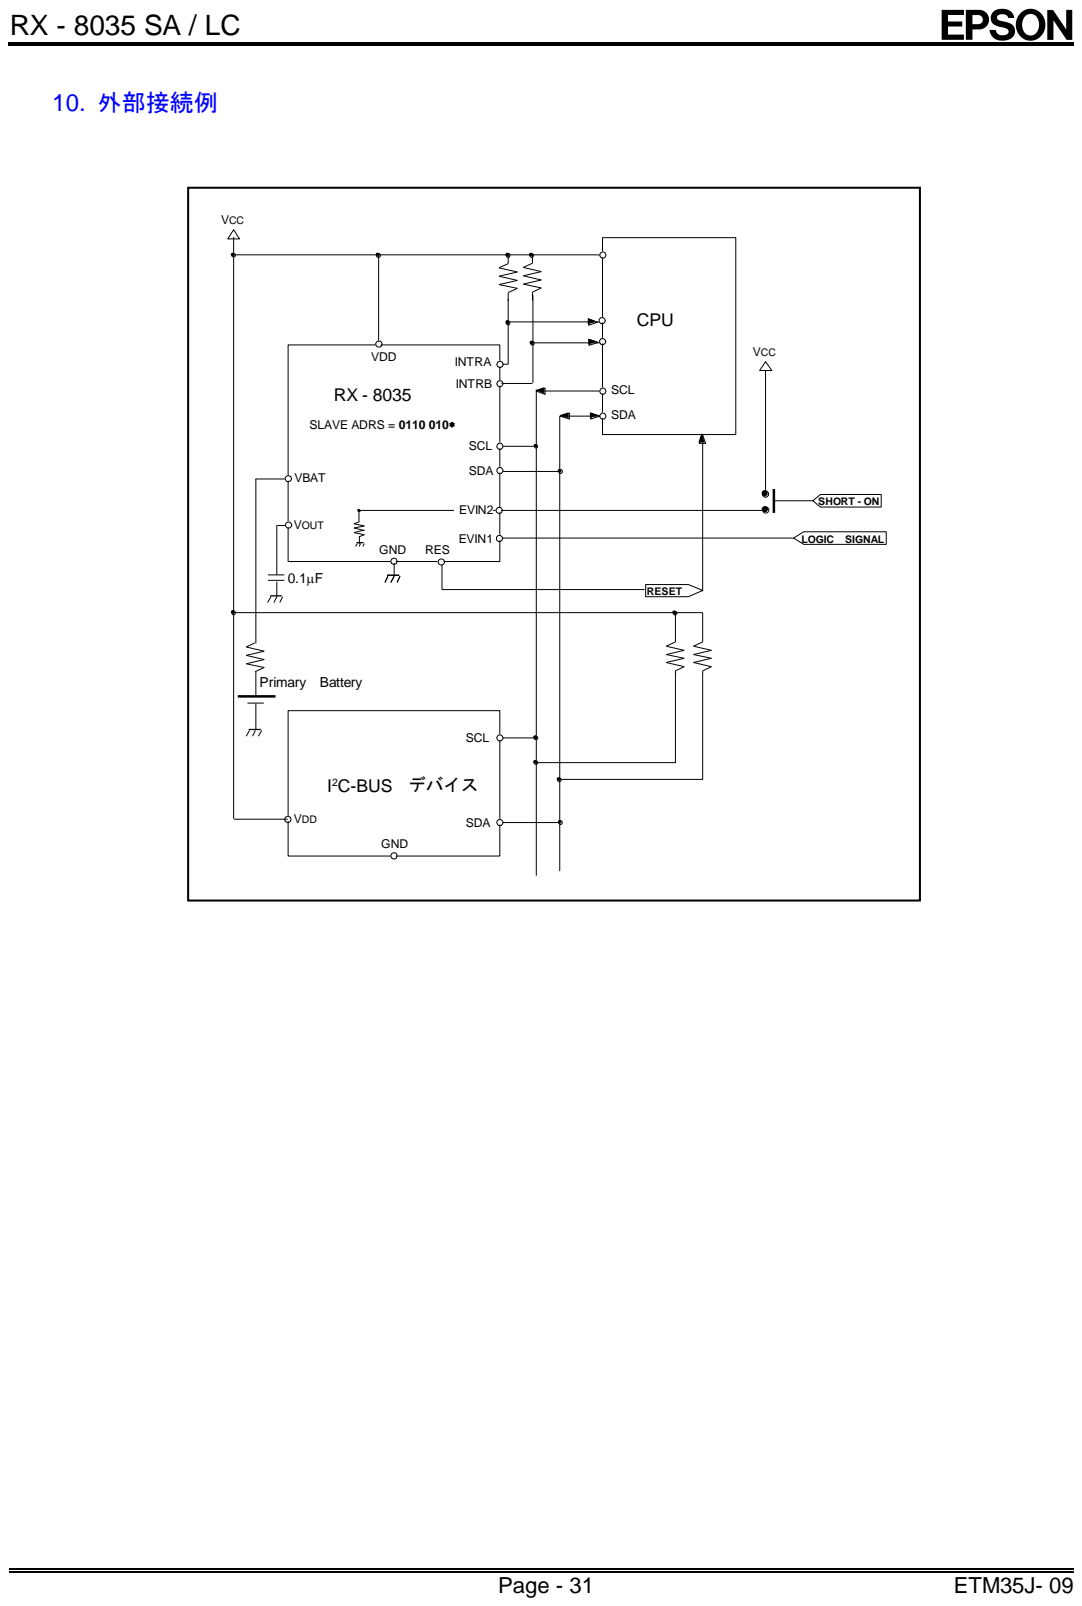
[picture p25: page 35]
Page - 31; ETM35J- 09; デバイス; SCL; SDA; GND; VDD; VCC; RES; SLAVE ADRS = 0110 010*; CPU; 2C-BUS; RESET; EVIN1; LOGIC SIGNAL; SHORT - ON; Primary Battery; VBAT; VOUT; INTRA; INTRB; EVIN2

## 11. 外形寸法図 / マーキングレイアウト

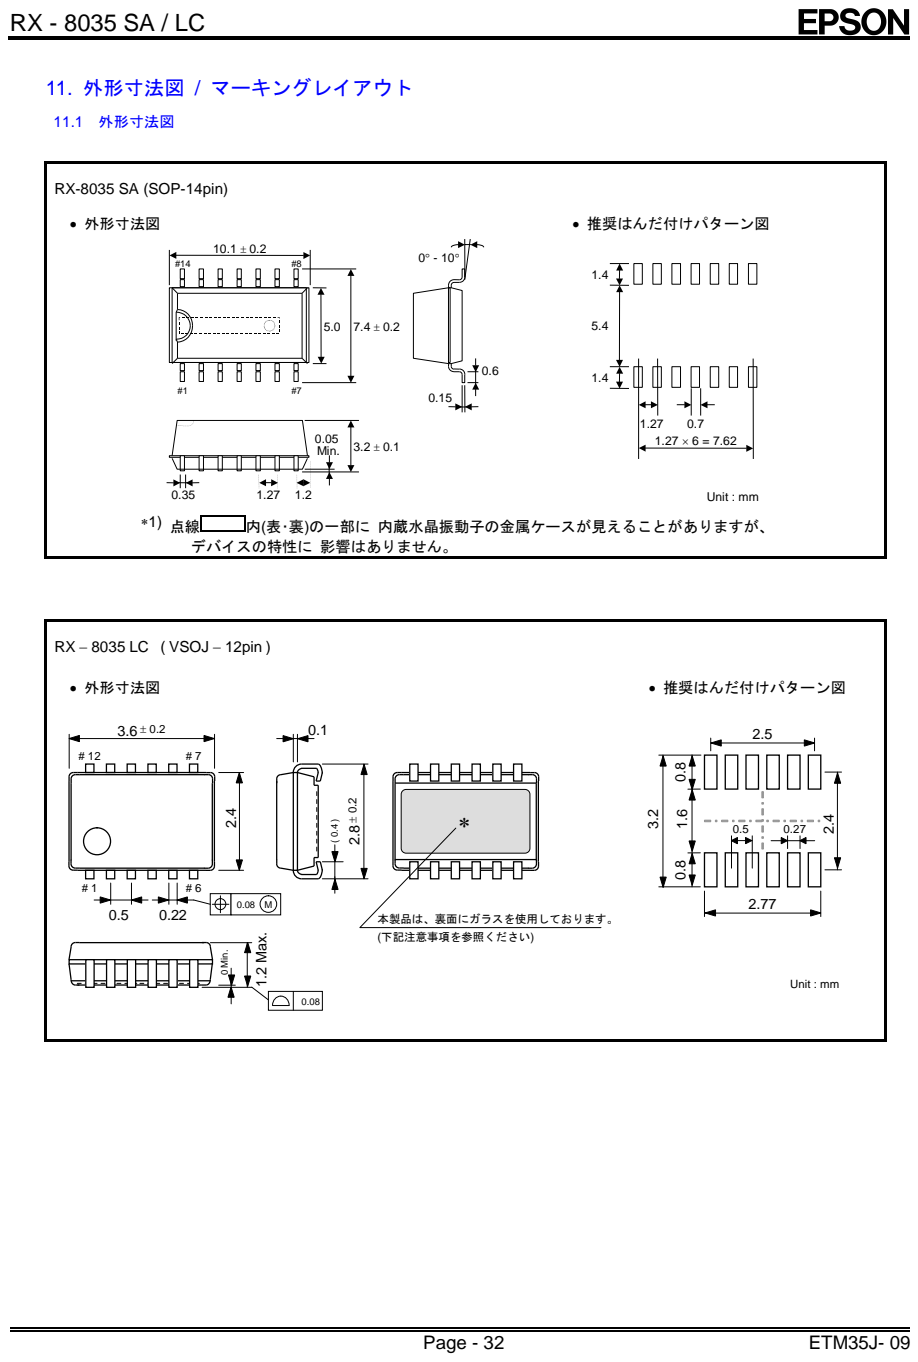
[picture p26: page 36]
Page - 32; ETM35J- 09; 11.1 外形寸法図; • 外形寸法図; • 推奨はんだ付けパターン図; Unit : mm; Min.; 内(表･裏)の一部に 内蔵水晶振動子の金属ケースが見えることがありますが、; デバイスの特性に 影響はありません。; 本製品は、裏面にガラスを使用しております。; (下記注意事項を参照ください) ².4 *; 0 Min. 1.2 Max.

RX-8035 SA (SOP-14pin)

RX - 8035 LC ( VSOJ - 12pin )

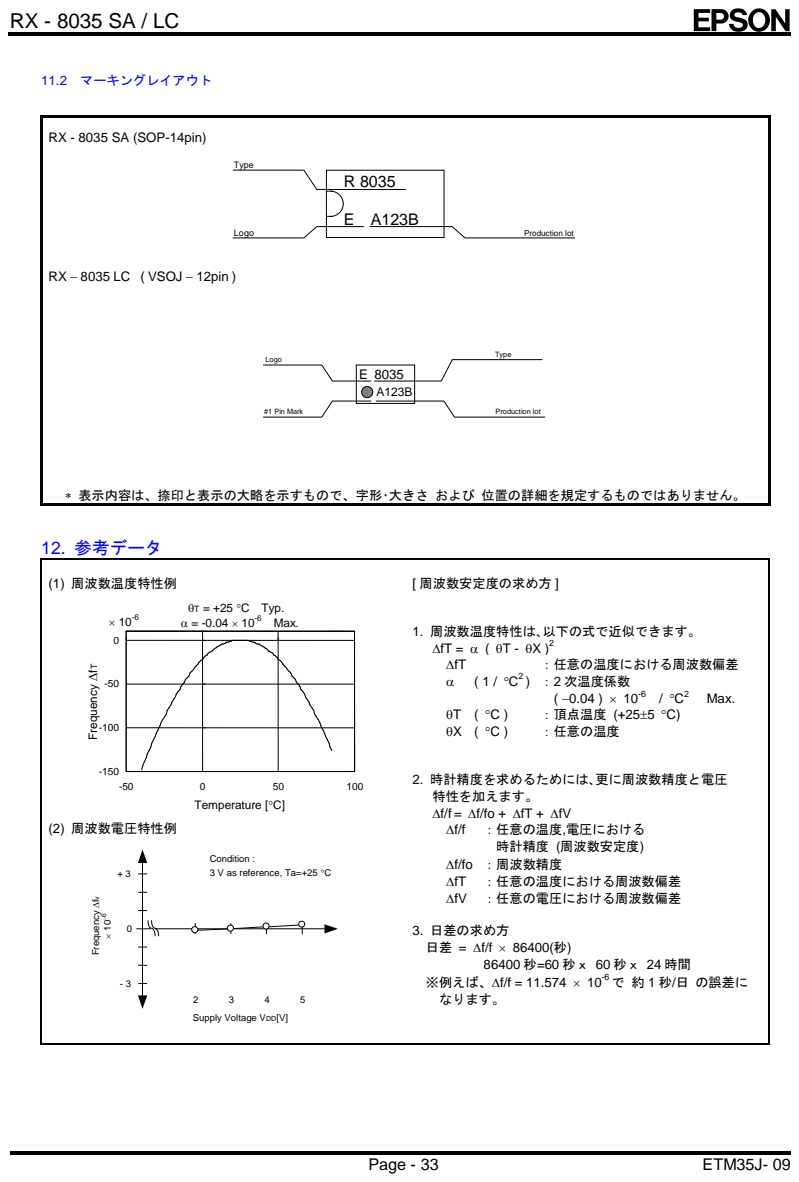
[picture p27: page 37]
Page - 33; ETM35J- 09; 11.2 マーキングレイアウト; Logo; Type; Production lot; #1 Pin Mark; 12. 参考データ; (1) 周波数温度特性例; θT = +25 °C Typ. α = -0.04 × 10⁻⁶; Max.; (2) 周波数電圧特性例; Frequency Δfv; [ 周波数安定度の求め方 ]; ΔfT; ：任意の温度における周波数偏差; 2 ) ：2 次温度係数 ( -0.04 ) × 10⁻⁶; ：頂点温度 (+25±5 °C); ：任意の温度; ：任意の温度,電圧における; 時計精度 (周波数安定度); ΔfV; ：任意の電圧における周波数偏差; 3. 日差の求め方 日差 = Δf/f × 86400(秒)

RX - 8035 SA (SOP-14pin)

RX - 8035 LC ( VSOJ - 12pin )

* 表示内容は、捺印と表示の大略を示すもので、字形･大きさ および 位置の詳細を規定するものではありません。

1. 周波数温度特性は､以下の式で近似できます。
ΔfT = α ( θT - θX )²

Temperature [°C] Frequency ΔfT

2. 時計精度を求めるためには､更に周波数精度と電圧
特性を加えます。
Δf/f = Δf/fo + ΔfT + ΔfV

Condition :
3 V as reference, Ta=+25 °C

Δf/fo ：周波数精度

※例えば、Δf/f = 11.574 × 10⁻⁶で 約 1 秒/日 の誤差に
なります。

Supply Voltage VDD[V]

Page - 34 | ETM35J- 09

## 13. 使用上の注意事項

1) 取り扱い上の注意事項

□ 本モジュールは 水晶振動子を内蔵していますので､ 過大な衝撃･振動を与えないようにしてください。
また､ 低消費電力実現のために C-MOS IC を用いておりますので､ 以下に注意して 使用してください。
(1) 静電気
耐静電気破壊保護回路は内蔵しておりますが､ 過大な静電気が加わると IC が破壊されるおそれがありますので､ 梱包 および 運搬容器 には 導電性の物を使用してください。 はんだごてや測定回路などは 高電圧リークの無いものを使用し､ また､ 実装時･作業時にも 静電気 対策をお願いいたします。
(2) ノイズ
電源 および 入出力端子に過大な外来ノイズが印加されますと､ 誤動作やラッチアップ現象等による 破壊の原因となることがあります。 安定動作のため､ 本モジュールの電源端子( VDD - GND 間)の極力近い場所に 0.1 µF 以上のパスコン(セラミックを推奨)を使用してくだ さい。 また､ 本モジュールの近くには､ 高ノイズを発生するデバイスを 配置しないようにしてください。
※ 図 1 の網掛部分( | )には信号線を接近させず､ 可能であれば GND パターンで埋めてください。
(3) 入力端子の電位
入力端子が中間レベルの電位になることは､ 消費電力の増加, ノイズマージンの減少, 素子の破壊等につながりますので､ VIL/VIH 仕様の 範囲でご使用ください。
(4) 未使用入力端子の処理
入力端子の入力インピーダンスは非常に高く､ 開放状態での使用は 不定電位やノイズによる誤動作の原因につながります。 未使用の入力端子は､ VDD または GND に電位固定してください
2) 実装上の注意事項
(1) はんだ付け温度
パッケージ内部が +260 °C を越えますと､ 水晶振動子の特性劣化 および 破壊を招く場合がありますので､ 弊社はんだ耐熱性評価プロ ファイルを越えない領域でのご使用を推奨します。 ご実装前に 必ず実装条件 ( 温度・時間 ) を ご確認ください。 また、条件変更時も 同様の確認をしていただいた後に ご使用ください。
※ 図 2 に､ 弊社 はんだ耐熱性評価プロファイル ( Ref. JEDEC J - STD - 020C ) を 掲載します。
(2) 実装機
本製品は裏面に硝子を使用しておりますので､ 使用機器, 条件等によっては 実装時の衝撃力により製品の破壊を招く場合があります。 ご使用の前には必ず､ 実装時の製品への負荷が極力少なくなる条件 ( 基板上への搭載速度を遅くする, チャックを弱くする など ) を確 認していただいてから ご使用ください。 条件変更時も､同様の確認をしていただいてから ご使用ください。 本製品と実装基板の間に異物などがありますと､ 製品の破壊を招く場合があります。 実装時には､ 異物にも ご注意ください。 また､ 実装時･作業時には､ 静電気対策をお願いいたします。
(3) 超音波
超音波を使用する機器（超音波洗浄機や超音波はんだ付け等）は 内蔵水晶振動子が共振破壊される場合がありますので、超音波機器をご使用 後の製品保証は いたしかねます。
(4) 実装方向
逆向きに実装しますと破壊の原因となります。 方向を確認した上で実装を行なってください。
(5) 端子間リーク
製品が汚れていたり結露している状態などで電源投入しますと 端子間リークを招く場合がありますので､ 洗浄し さらに 乾燥させた後 に電源投入を行なってください。
(6) 製品実装後の接着剤の使用禁止
本製品は パッケージの裏面に硝子を使用しています。 本製品を基板実装後に、アンダーフィル等の接着剤が 実装面とガラス面の間に侵 入すると、その後、接着剤の熱膨張などにより硝子が割れる可能性があります。この場合は、水晶発振が停止しますので、接着剤はご使用 を中止していただくか、本製品に接着剤が接近しないように、実装上の配慮をお願いいたします。
RX - 8035 LC

( VSOJ - 12 pin )

RX - 8035 SA

( SOP - 14 pin )

※網掛部分( )には信号線を
接近させず､ 可能であれば GND
パターンで埋めてください。

Temperature [ °C ]

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
60 s to 180 s

( +150 °C to +200 °C )

Avg. Ramp-up
+3 °C / s Max.
-6 °C / s Max.

Time [ s ]

120 180 240 300 360 420 480 540 600 660 720 780

Ts min ; +150 °C

Ts max ; +200 °C

TL ; +217 °C +255 °C

tL
60 s to 150 s

( +217 °C over )

tp ; 20 s to 40 s

TP ; +260 °C

Time +25 °C to Peak

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
