SnyUmd/KiCAD/HCT/ハッカソンデバイス回路図.pdf

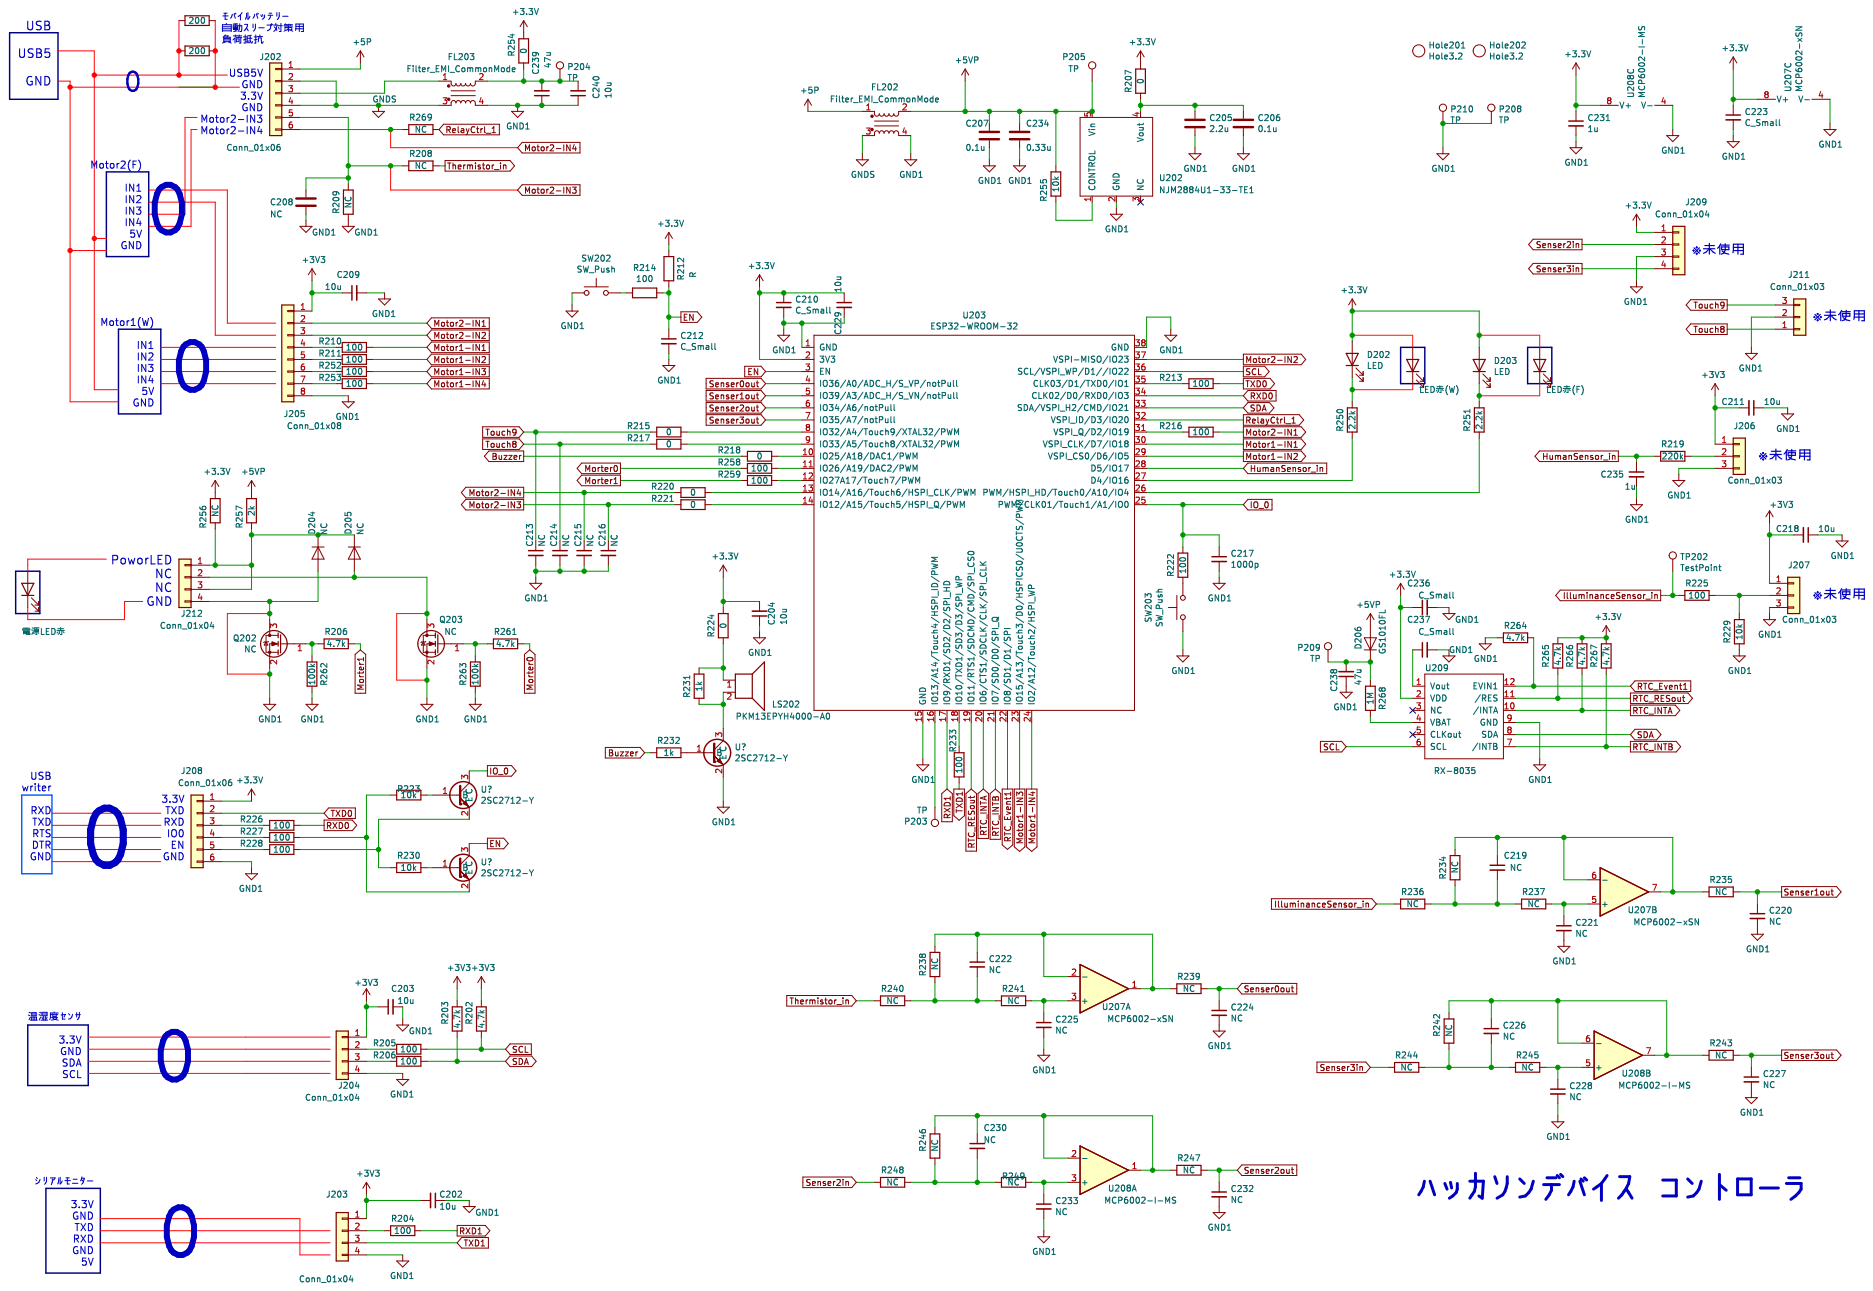
[picture p29: page 1]
