SnyUmd/KiCAD/spot/HCT_Device/ハッカソンデバイス回路図.pdf

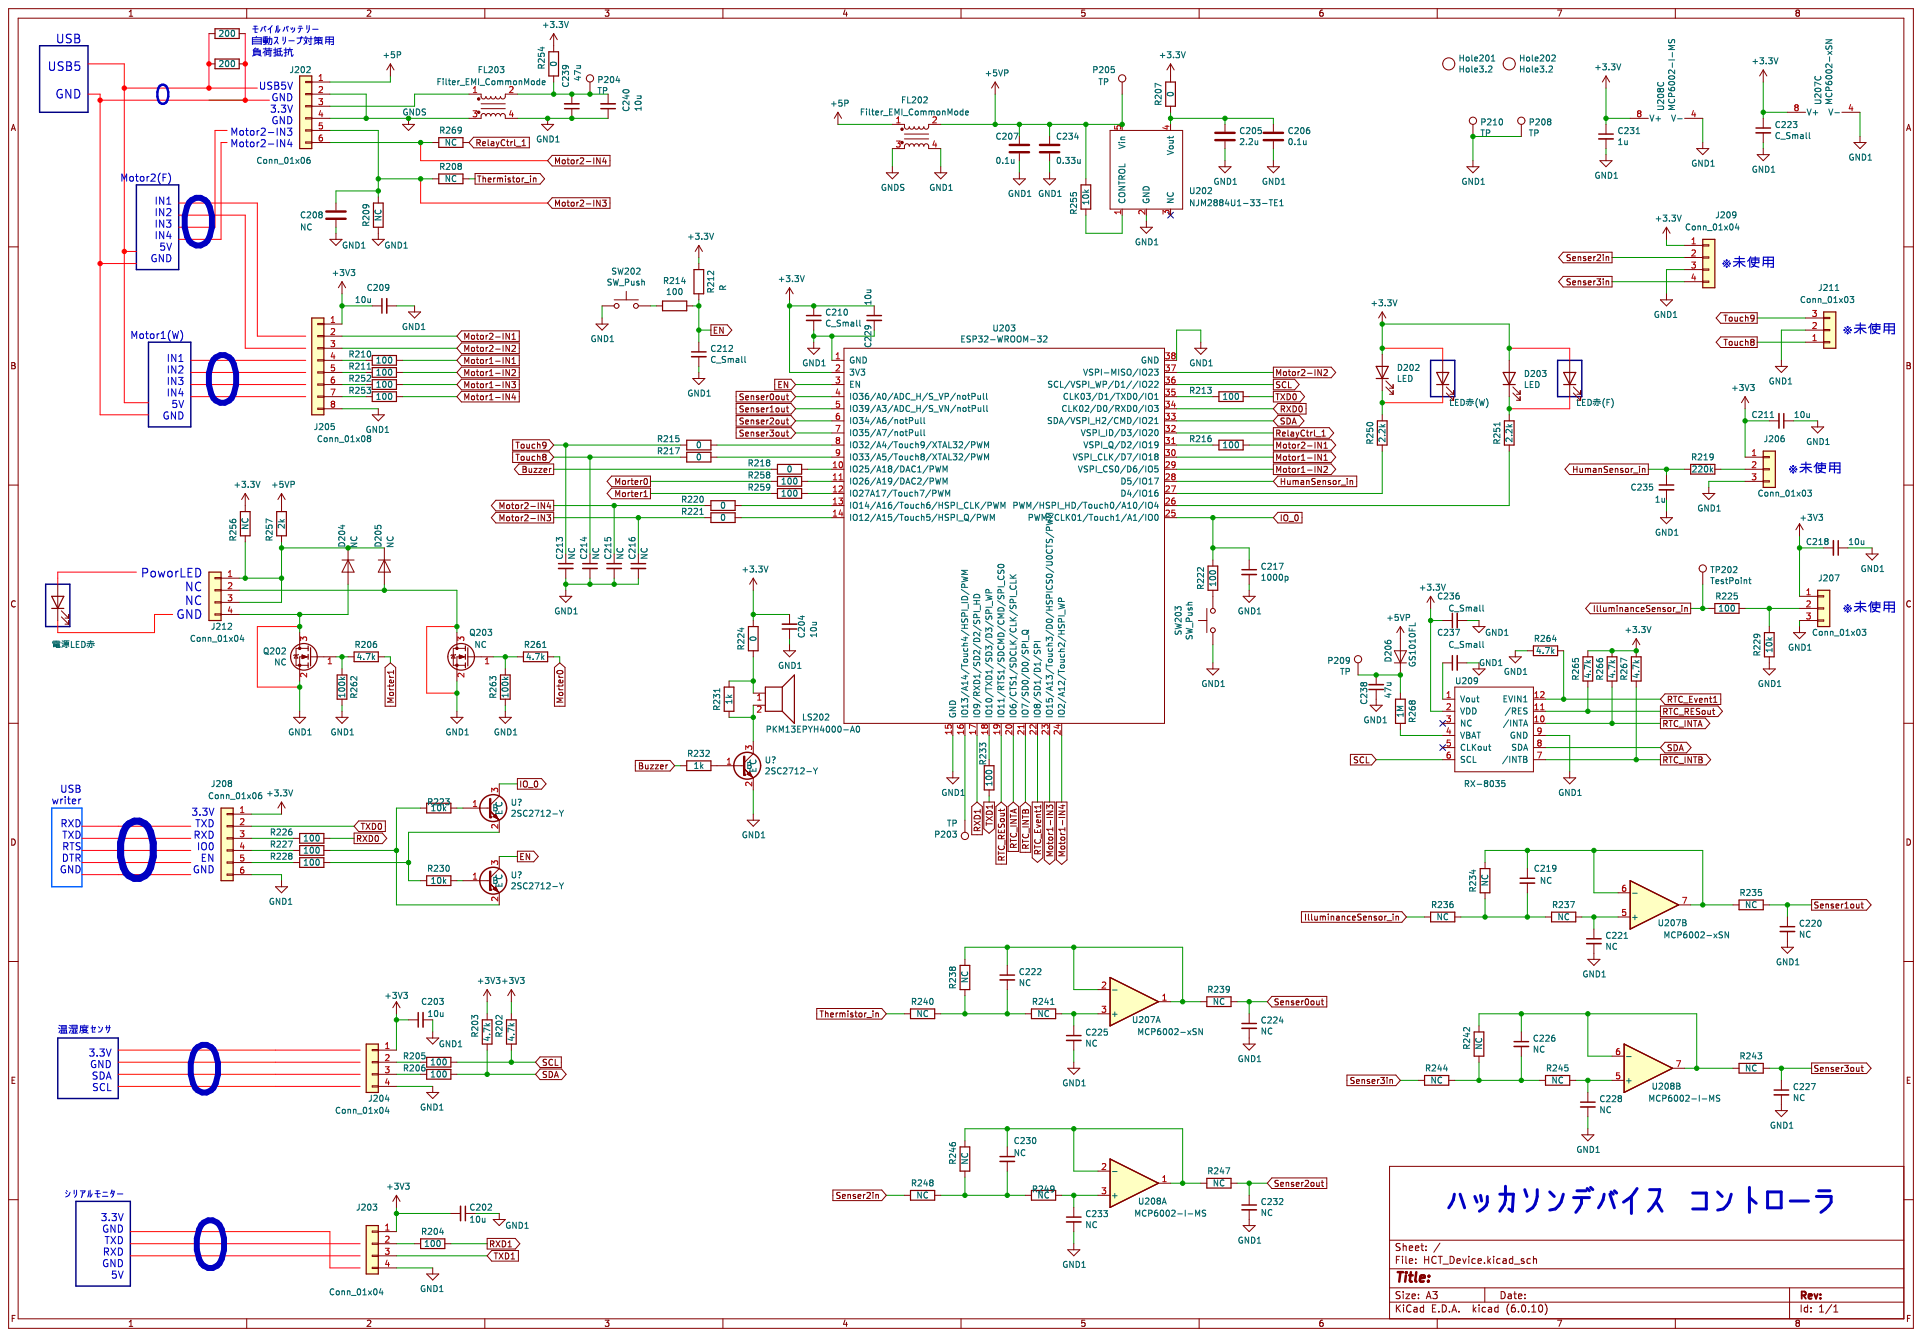
[picture p30: page 1]
