SnyUmd/KiCAD/(commit log)

2022-09-21 初回コミット
    [Block.sch, CapSorting.sch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]
2022-09-27 着信お知らせプロジェクト作成
    [CallNotification.kicad_pcb, CallNotification.sch, CallNotification_.sch]
